celytiorja/lab-Brazo-planar/docs/marcadores_aruco.pdf

## Marcadores ArUco: teleoperación con cámara

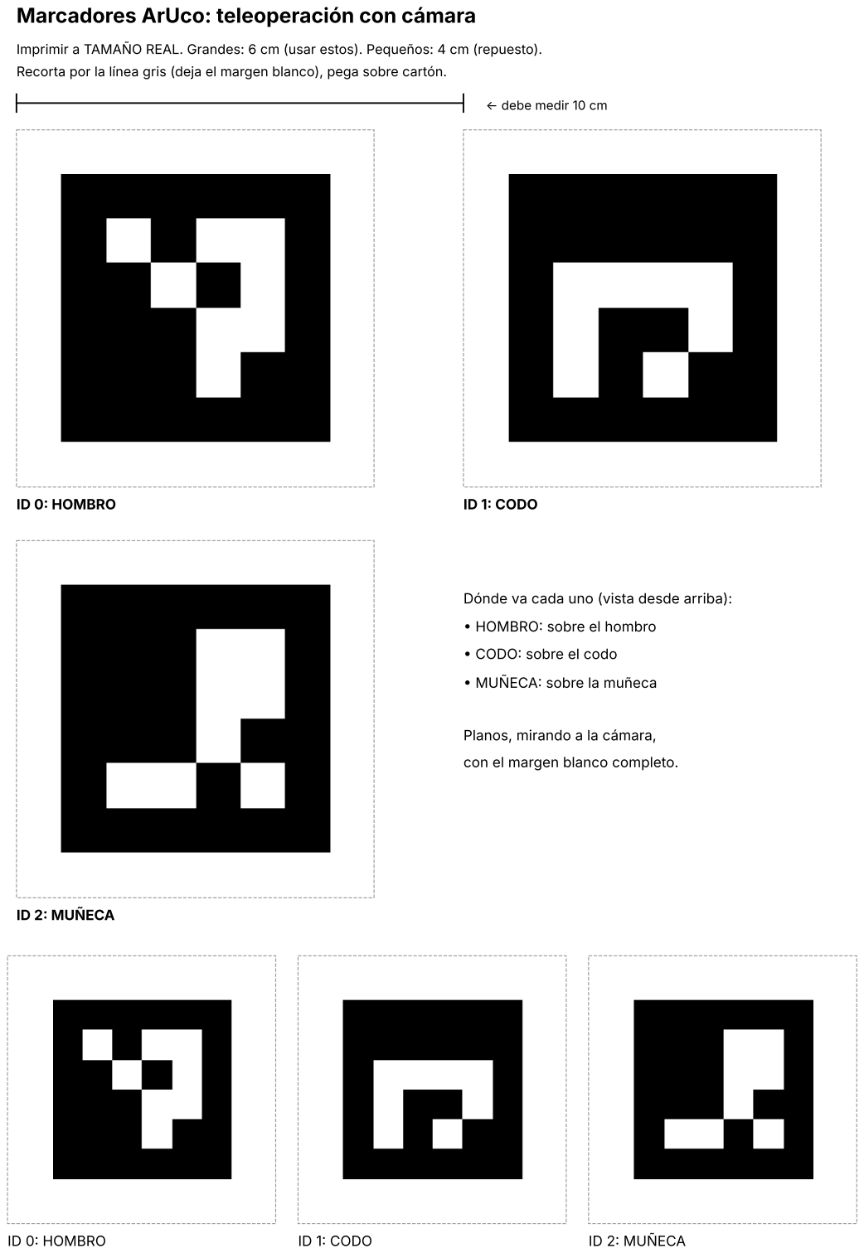
[picture p8: page 1]

Imprimir a TAMAÑO REAL. Grandes: 6 cm (usar estos). Pequeños: 4 cm (repuesto).

Recorta por la línea gris (deja el margen blanco), pega sobre cartón.

← debe medir 10 cm

ID 0: HOMBRO

ID 0: HOMBRO

ID 1: CODO

ID 1: CODO

ID 2: MUÑECA

ID 2: MUÑECA

Dónde va cada uno (vista desde arriba):
- HOMBRO: sobre el hombro
- CODO: sobre el codo
- MUÑECA: sobre la muñeca

Planos, mirando a la cámara,

con el margen blanco completo.
