celytiorja/lab-Brazo-planar/docs/05_teleoperacion_camara.md

# Teleoperación con la cámara del teléfono (Entrega 2)

El robot copia **tu brazo**. El teléfono, arriba de la mesa, ve tres marcadores impresos
(cuadros ArUco) en tu hombro, codo y muñeca.
Python calcula tus ángulos θ1 y θ2, los filtra con **Kalman** y se los manda al robot.

```
Teléfono (DroidCam, WiFi) → PC: marcadores → θ1, θ2 → Kalman → ESP32 → servos
```

## 1. Materiales (10 minutos)

### Por qué cuadros ArUco y no papeles de color

Con papeles de color el programa busca "píxeles parecidos al azul que aprendió". Eso falla
fácil: con poca luz el azul claro se vuelve **gris**, con mucha luz se vuelve **blanco**, y si
algo del fondo tiene un color parecido, lo confunde. (Fue lo que pasó con el hombro.)

Un **ArUco** es como un código QR pequeñito: borde negro y 4×4 casillas blanco/negro.

| | Papel de color | Cuadro ArUco |
|---|---|---|
| Qué busca | un tono de color | un cuadrado con borde negro y casillas |
| Con poca o mucha luz | el color cambia y se pierde | blanco y negro se distinguen siempre |
| ¿Cuál es cuál? | depende de dónde estaba antes | el cuadro **dice su número** (ID 0, 1, 2) |
| Fondo parecido | lo confunde | imposible: el código tiene bits de verificación |
| Precisión del centro | mancha de bordes difusos | 4 esquinas exactas (sub-píxel) → menos R |
| Hay que calibrar | sí (clic en cada color) | no |

Su punto débil: si te mueves **muy rápido** la imagen sale borrosa y ese cuadro no se lee.
Ahí es justo donde ayuda **Kalman**: predice con su modelo hasta que lo vuelve a ver.

### Lo que necesitas

1. **Imprimir la hoja** `docs/marcadores_aruco.pdf` a **tamaño real** (100 %, sin "ajustar
   a la página"). Mide con una regla la línea de 10 cm de la hoja. Si no tienes impresora,
   `python python/generar_marcadores.py` muestra cada cuadro para dibujarlo a mano en papel
   cuadriculado (6×6 casillas con marcador negro).
2. Recortar los **3 cuadros grandes (6 cm)** por la línea gris punteada, **dejando el margen
   blanco**, y pegarlos sobre cartón para que queden **planos**.
3. Pegarlos (cinta) **encima** de tu brazo, mirando hacia la cámara:
   **ID 0 → hombro**, **ID 1 → codo**, **ID 2 → muñeca**. Da igual cómo queden girados.
4. **El teléfono arriba de la mesa, mirando hacia abajo**, a unos 60–80 cm, con tu brazo
   completo en la imagen. Sirve un trípode, una lámpara o una caja.

## 2. El teléfono como cámara (una vez)

1. Instala **DroidCam** en el teléfono (Play Store o App Store).
2. El teléfono y el PC deben estar en la **misma red WiFi**.
3. Abre DroidCam: muestra una dirección como `WiFi IP: 192.168.1.23` y `Port: 4747`.
4. Tu fuente de video es `http://192.168.1.23:4747/video` (con tu IP).

## 3. Instalar OpenCV (una vez)

En la terminal de VS Code, con `(.venv)`:

```
git pull
pip install -r requirements.txt
```

## 4. Primera prueba, SIN robot

```
python python/teleop_camara.py --video http://192.168.1.23:4747/video
```

1. Muestra los 3 cuadros a la cámara. Cada uno aparece **enmarcado** con su color (azul
   hombro, verde codo, rojo muñeca) y unidos por una **línea amarilla**. Abajo de los
   ángulos dice `aruco: hombro:si codo:si muneca:si`.
2. Pon el brazo **estirado hacia adelante** (alejándose de ti) y pulsa **C**. Esa pose pasa a
   valer (90°, 0°), igual que la posición de inicio del robot.
3. Brazo **quieto** y pulsa **N**: durante 10 s mide cuánto "tiembla" la detección. Esa es la
   **R de la cámara**, igual que hiciste con las IMU en la Entrega 1.
4. Mueve el brazo: arriba ves los ángulos **crudos** y los de **Kalman**.

Si un cuadro no se detecta, pulsa **D** (diagnóstico): se dibujan en **rojo fino** los
cuadrados que la cámara ve pero no logra leer.

| Lo que ves | Causa probable | Arreglo |
|---|---|---|
| Ni siquiera un recuadro rojo | muy pequeño en la imagen | acerca el teléfono o usa cuadros más grandes |
| Recuadro rojo pero no se lee | borroso, doblado, brillo o sin margen blanco | pégalo en cartón, deja el margen, evita el reflejo de la lámpara |
| Se pierde solo al moverte rápido | desenfoque de movimiento | más luz (la cámara expone menos tiempo); Kalman cubre esos cuadros |
| Dice `hombro (memoria)` | el hombro no se vio en ese cuadro | normal: el hombro casi no se mueve y se usa su última posición |

Respaldo con papeles de color: `--modo color` y la tecla **L** (clic en hombro, codo y muñeca).

## 5. Con el robot

ESP32 con `firmware/adquisicion` y el Monitor Serie cerrado:

```
python python/teleop_camara.py --video http://192.168.1.23:4747/video --puerto COM3
```

- El robot **arranca en PAUSA**. Pulsa **R** para que empiece a copiarte. Hazlo con tu brazo en
  la pose de inicio, para que no dé un salto.
- **F** cambia lo que mueve al robot: **crudo** (la cámara tal cual) o **Kalman**.
- **1**, **2** y **3** cambian la configuración Q (baja, media o alta).

## 6. Grabar sesiones para la evidencia (E8 y C2)

**G** inicia y detiene la grabación. Queda en `datos/teleop/sesion_XX.csv` y **se sube sola a
GitHub**. Al salir (Q), `analisis_teleop.py` analiza todas las sesiones y sube los resultados.

Crudo y Kalman se calculan **siempre los dos**, en cada cuadro. La comparación de ángulos se hace
en los mismos cuadros y no hacen falta sesiones aparte. Lo que sí cambia según **F** es qué mueve
al robot. Por eso se graban dos sesiones con el mismo protocolo (la pantalla guía los tiempos):

| Sesión | F (mueve al robot) | 0–10 s | 10–20 s | 20–30 s |
|---|---|---|---|---|
| 1 | crudo | lento | rápido | tapa la muñeca 2 veces |
| 2 | Kalman | lento | rápido | tapa la muñeca 2 veces |

Paso a paso: `docs/PRUEBA_FINAL.md`.

## 6b. Por qué ya no "se traba" (latencia)

OpenCV guardaba los cuadros en una fila. Si el programa tardaba un poco, cada cuadro mostrado era
más viejo que el anterior y el retraso crecía hasta varios segundos. `python/video_rapido.py` lee
el video en un hilo aparte, se queda solo con el cuadro más nuevo y bota los viejos sin
decodificarlos. `python python/prueba_latencia_video.py` lo mide con un DroidCam falso:

| | edad del cuadro al inicio | después de 8 s |
|---|---|---|
| `cv2.VideoCapture` (antes) | 75 ms | **2205 ms** (crece sin parar) |
| `LectorVideo` (ahora) | 15 ms | **17 ms** |

Lo que el código no arregla es la WiFi: usa el **hotspot del teléfono** (ping de pocos ms).

## 7. Qué decir (por qué Kalman ayuda aquí)

- **La cámara tiembla** (lo mide R) y llega a ~30 cuadros/s con Δt irregular. Kalman usa el Δt
  real de cada cuadro y entrega movimientos **más suaves** al servo.
- **Si un marcador se tapa**, la cámara cruda se queda congelada. Kalman **sigue
  prediciendo** con su modelo (velocidad casi constante) hasta que vuelve a verlo.
  - Si solo se tapa la muñeca, θ1 se sigue midiendo: H se queda con su fila (**medición
    parcial**) y solo θ2 se predice.
  - Si la oclusión es larga, la velocidad estimada se frena para que el robot no siga de largo.
- **Q de la cámara:** q = r·Δt·(2π f_n)⁴ (r = varianza por cuadro medida con N; r·Δt la
  convierte en densidad). Las 3 configuraciones (f_n = 1,5 / 3 / 6 Hz) están caracterizadas en
  `resultados/<origen>/teleop/configuraciones_q_camara.md`. Q_media reduce el temblor de 8 Hz a
  la mitad con menos de 16 ms de retraso hasta 2 Hz.
- **No hay deriva**: la cámara mide el ángulo directamente. Es el complemento perfecto de las
  IMU, que no tiemblan pero derivan. **Fusionarlas** (cámara + giroscopios en tu brazo) es el
  paso siguiente; el código ya está preparado (`python/kalman_camara.py`).
