celytiorja/lab-Brazo-planar/docs/marcadores_aruco.png

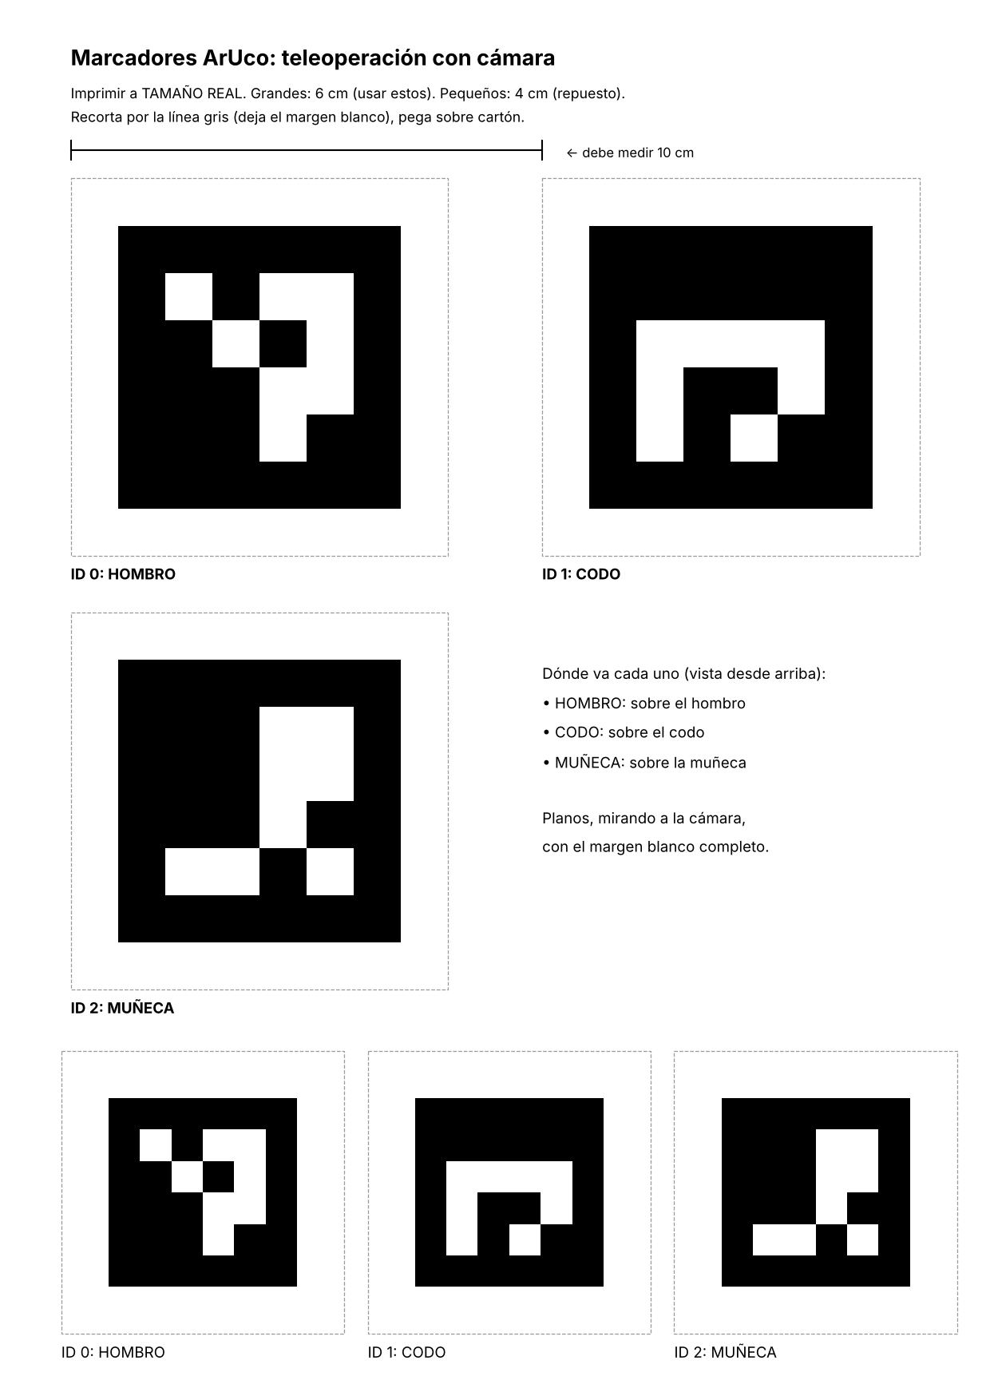
docs/marcadores_aruco.png
