celytiorja/lab-Brazo-planar/resultados/sinteticos/e1/verificacion_cinematica_resumen.md

# Verificación cinemática: resumen

| tipo | n | rmse_mm | media_mm | max_mm | sigma_resolucion_media_mm |
| --- | --- | --- | --- | --- | --- |
| todos | 20 | 5.95 | 5.831 | 8.239 | 0.9917 |
| directa | 10 | 6.21 | 6.069 | 8.239 | 1.037 |
| inversa | 10 | 5.677 | 5.593 | 7.158 | 0.9464 |

Fuentes de error (mínimos cuadrados sobre todos los puntos): offset θ1 = +0.62°, offset θ2 = +2.67°. RMSE 5.95 mm → 1.44 mm al corregirlos. Repetibilidad media 1.74 mm. Resolución de 1° ≈ 0.99 mm.
