celytiorja/lab-Brazo-planar/resultados/reales/teleop/metricas_teleop_completas.md

# Teleoperación: todas las métricas

| sesion | robot_movido_con | duracion_s | cuadros | fps | dt_medio_ms | dt_std_ms | dt_max_ms | visto_pct | solo_theta1_pct | hombro_memoria_pct | oclusiones | oclusion_max_ms | aspereza_theta1_crudo | aspereza_theta1_kf | aspereza_theta2_crudo | aspereza_theta2_kf | ordenes_s_crudo | ordenes_s_kf | cambios_dir_s_hombro_crudo | cambios_dir_s_hombro_kf | cambios_dir_s_codo_crudo | cambios_dir_s_codo_kf | retraso_kf_theta1_ms | retraso_kf_theta2_ms | t_kalman_us_medio | t_kalman_us_p95 | t_proc_ms_medio | t_proc_ms_p95 | carga_pct | imu_robot_valida_pct | retraso_orden_robot_hombro_ms | error_seguimiento_hombro_deg | retraso_camara_robot_hombro_ms | vibracion_robot_hombro_dps | retraso_orden_robot_codo_ms | error_seguimiento_codo_deg | retraso_camara_robot_codo_ms | vibracion_robot_codo_dps | imu_robot_falla_t_s |
| --- | --- | --- | --- | --- | --- | --- | --- | --- | --- | --- | --- | --- | --- | --- | --- | --- | --- | --- | --- | --- | --- | --- | --- | --- | --- | --- | --- | --- | --- | --- | --- | --- | --- | --- | --- | --- | --- | --- | --- |
| sesion_01 | kalman | 73.65 | 1102 | 14.95 | 66.89 | 80.43 | 781.9 | 83.48 | 16.52 | 1.452 | 34 | 1863 | 1.436 | 1.184 | 2.945 | 2.069 | 4.847 | 5.798 | 0.7468 | 0.7875 | 0.6925 | 0.8011 | 5 | 5 | 260.1 | 426.8 | 6.377 | 13.69 | 9.533 | 100 | 200 | 2.3 | 210 | 3.258 | 170 | 4.02 | 205 | 8.832 | — |
| sesion_02 | sin robot | 7.361 | 96 | 12.91 | 77.49 | 69.04 | 381.9 | 100 | 0 | 0 | 0 | 0 | 0.1631 | 0.1315 | 1.447 | 0.9537 | 4.211 | 4.211 | 0.5434 | 0.5434 | 0.6792 | 0.6792 | 5 | 5 | 297.4 | 534.5 | 6.758 | 12.03 | 8.722 | — | — | — | — | — | — | — | — | — | — |
| sesion_03 | crudo | 43.55 | 495 | 11.34 | 88.15 | 139.7 | 2174 | 94.34 | 5.657 | 0 | 2 | 2996 | 0.8636 | 0.6696 | 2.204 | 1.654 | 3.353 | 3.605 | 0.3215 | 0.3215 | 0.2985 | 0.2985 | 5 | 5 | 269.2 | 433.3 | 6.585 | 11.91 | 7.471 | 86.19 | 185 | 0.9911 | 220 | 1.863 | 175 | 3.388 | 200 | 6.46 | 37.79 |
| sesion_04 | kalman | 38.05 | 523 | 13.72 | 72.9 | 132.7 | 2298 | 95.98 | 4.015 | 0 | 3 | 705.4 | 0.9866 | 0.7231 | 2.822 | 2.088 | 4.336 | 4.862 | 0.8146 | 0.8672 | 0.5519 | 0.6044 | 10 | 10 | 261.5 | 420.1 | 6.374 | 11.32 | 8.744 | 0 | — | — | — | — | — | — | — | — | 0.1582 |
