celytiorja/lab-Brazo-planar/resultados/reales/e1/estadisticas_estatico.md

# Estadística en reposo

| canal | unidad | media | varianza | desv_est | min | max |
| --- | --- | --- | --- | --- | --- | --- |
| ax1 | g | 0.0008008 | 6.24e-06 | 0.002498 | -0.007935 | 0.009521 |
| gx1 | °/s | -4.87 | 0.001793 | 0.04234 | -5.069 | -4.58 |
| ay1 | g | -0.005908 | 2.72e-06 | 0.001649 | -0.01257 | 0.002563 |
| gy1 | °/s | 0.844 | 0.001315 | 0.03627 | 0.626 | 1.099 |
| az1 | g | 1.033 | 5.408e-06 | 0.002326 | 1.022 | 1.048 |
| gz1 | °/s | 0.2604 | 0.0008918 | 0.02986 | 0.1679 | 0.3664 |
| ax2 | g | 0.04436 | 3.035e-06 | 0.001742 | 0.03784 | 0.05042 |
| gx2 | °/s | -3.484 | 0.001486 | 0.03854 | -3.847 | -3.237 |
| ay2 | g | -0.02976 | 2.034e-06 | 0.001426 | -0.03528 | -0.02405 |
| gy2 | °/s | -0.3958 | 0.002571 | 0.0507 | -0.6565 | -0.07634 |
| az2 | g | 0.9215 | 6.733e-06 | 0.002595 | 0.9115 | 0.9342 |
| gz2 | °/s | -0.504 | 0.001062 | 0.03259 | -0.6412 | -0.3817 |
| w1 (giro en el plano) | °/s | 0.2604 | 0.0008918 | 0.02986 | 0.1679 | 0.3664 |
| w2 (giro en el plano) | °/s | -0.504 | 0.001062 | 0.03259 | -0.6412 | -0.3817 |

Archivo: estatico_03. Generado por código · commit 54720e5+cambios_sin_commit · manifiesto datos/crudos/manifiesto.json
