celytiorja/lab-Brazo-planar/resultados/reales/e1/sensibilidad_ventana.md

# Sensibilidad al tamaño de ventana N

| N | eslabon | ruido_omega_reposo_dps | ruido_teorico_dps | retraso_ms | retraso_teorico_ms | error_estacionario_rms_deg | deriva_final_deg |
| --- | --- | --- | --- | --- | --- | --- | --- |
| 1 | 1 | 0.02987 | 0.02986 | 0 | 0 | 5.759 | 6.004 |
| 1 | 2 | 0.03259 | 0.03259 | 0 | 0 | 4.425 | 7.698 |
| 3 | 1 | 0.02003 | 0.01724 | 9.22 | 10 | 5.759 | 6.003 |
| 3 | 2 | 0.0211 | 0.01881 | 9.822 | 10 | 4.425 | 7.697 |
| 5 | 1 | 0.01629 | 0.01336 | 19.2 | 20 | 5.758 | 6.002 |
| 5 | 2 | 0.01676 | 0.01457 | 19.81 | 20 | 4.425 | 7.697 |
| 9 | 1 | 0.01261 | 0.009955 | 39.16 | 40 | 5.758 | 6 |
| 9 | 2 | 0.01262 | 0.01086 | 39.79 | 40 | 4.424 | 7.696 |
| 15 | 1 | 0.01021 | 0.007711 | 69.07 | 70 | 5.76 | 5.998 |
| 15 | 2 | 0.009736 | 0.008414 | 69.76 | 70 | 4.421 | 7.693 |
| 21 | 1 | 0.008977 | 0.006517 | 98.95 | 100 | 5.763 | 5.995 |
| 21 | 2 | 0.008139 | 0.007111 | 99.72 | 100 | 4.421 | 7.691 |
| 31 | 1 | 0.007774 | 0.005364 | 148.7 | 150 | 5.799 | 5.992 |
| 31 | 2 | 0.006682 | 0.005853 | 149.7 | 150 | 4.468 | 7.688 |
| 51 | 1 | 0.006604 | 0.004182 | 247.9 | 250 | 6.334 | 5.985 |
| 51 | 2 | 0.005133 | 0.004563 | 249.5 | 250 | 5.287 | 7.683 |

Media móvil de ruido blanco: σ_N = σ/√N y retraso (N−1)/2 muestras. La deriva final NO cambia con N: promediar no quita el sesgo.
