celytiorja/lab-Brazo-planar/resultados/reales/e2/compromiso_Q_R.md

# Barrido de q (compromiso Q/R)

| archivo | f_objetivo_hz | q | q_dt_sobre_r | K_omega_estacionaria | f_corte_hz | ruido_omega_reposo_puro_dps | ruido_omega_reposo_perfil_dps | retraso_omega_ms |
| --- | --- | --- | --- | --- | --- | --- | --- | --- |
| escalones_01 | 0.3 | 3.471e-05 | 0.0003892 | 0.01867 | 0.3 | 0.00449 | 0.289 | 128.6 |
| escalones_01 | 0.426 | 6.999e-05 | 0.0007848 | 0.02641 | 0.426 | 0.005071 | 0.1005 | 113.3 |
| escalones_01 | 0.604 | 0.0001407 | 0.001578 | 0.03724 | 0.604 | 0.00579 | 0.07442 | 98.05 |
| escalones_01 | 0.856 | 0.0002826 | 0.003169 | 0.05236 | 0.856 | 0.006668 | 0.08821 | 82.32 |
| escalones_01 | 1.214 | 0.0005686 | 0.006376 | 0.07344 | 1.214 | 0.007734 | 0.1059 | 66.98 |
| escalones_01 | 1.722 | 0.001145 | 0.01283 | 0.1025 | 1.722 | 0.00901 | 0.1269 | 52.92 |
| escalones_01 | 2.442 | 0.002304 | 0.02584 | 0.1422 | 2.442 | 0.01052 | 0.1517 | 40.53 |
| escalones_01 | 3.464 | 0.004646 | 0.05209 | 0.1956 | 3.464 | 0.01229 | 0.1801 | 29.84 |
| escalones_01 | 4.913 | 0.009382 | 0.1052 | 0.2656 | 4.913 | 0.01433 | 0.2114 | 20.98 |
| escalones_01 | 6.969 | 0.01903 | 0.2134 | 0.3546 | 6.969 | 0.01665 | 0.2439 | 13.99 |
| escalones_01 | 9.884 | 0.0389 | 0.4362 | 0.4626 | 9.884 | 0.0192 | 0.2755 | 9.198 |
| escalones_01 | 14.02 | 0.08082 | 0.9062 | 0.5856 | 14.02 | 0.02193 | 0.3039 | 5.544 |
| escalones_01 | 19.88 | 0.1734 | 1.944 | 0.7133 | 19.88 | 0.0247 | 0.3271 | 3.1 |
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
| seno_rapido_01 | 28.2 | 0.3959 | 4.439 | 0.83 | 28.2 | 0.02726 | 0.04245 | 1.357 |
| seno_rapido_01 | 40 | 1.018 | 11.42 | 0.919 | 40 | 0.02929 | 0.04454 | 0.5926 |

Generado por código · commit 54720e5+cambios_sin_commit · manifiesto datos/crudos/manifiesto.json
