celytiorja/lab-Brazo-planar/resultados/reales/e2/ruido_reposo_puro.md

# Ruido de ω en reposo puro (estatico_03)

| metodo | ruido_omega_reposo_puro_dps |
| --- | --- |
| Integración directa | 0.03123 |
| Media móvil N=5 + Euler | 0.01655 |
| Media móvil N=21 + Euler | 0.008579 |
| Kalman Q_baja | 0.008479 |
| Kalman Q_media | 0.01444 |
| Kalman Q_alta | 0.02247 |

σ de la velocidad estimada con el brazo quieto (sin movimiento previo). Mide SOLO ruido, sin mezclar retraso.

Generado por código · commit 54720e5+cambios_sin_commit · manifiesto datos/crudos/manifiesto.json
