celytiorja/lab-Brazo-planar/resultados/sinteticos/e1/estadisticas_estatico.md

# Estadística en reposo

| canal | unidad | media | varianza | desv_est | min | max |
| --- | --- | --- | --- | --- | --- | --- |
| ax1 | g | -6.334e-06 | 9.342e-06 | 0.003056 | -0.009888 | 0.01123 |
| gx1 | °/s | 0.001145 | 0.003506 | 0.05921 | -0.2137 | 0.2137 |
| ay1 | g | -1.799e-05 | 9.143e-06 | 0.003024 | -0.009766 | 0.01074 |
| gy1 | °/s | -0.0001756 | 0.003512 | 0.05927 | -0.1832 | 0.1985 |
| az1 | g | 1 | 8.92e-06 | 0.002987 | 0.9891 | 1.012 |
| gz1 | °/s | 0.355 | 0.003665 | 0.06054 | 0.1374 | 0.5802 |
| ax2 | g | -1.067e-05 | 9.332e-06 | 0.003055 | -0.01001 | 0.01038 |
| gx2 | °/s | 0.0002023 | 0.003642 | 0.06035 | -0.1985 | 0.2137 |
| ay2 | g | -1.735e-05 | 8.95e-06 | 0.002992 | -0.009949 | 0.01007 |
| gy2 | °/s | 0.0009201 | 0.003638 | 0.06031 | -0.1985 | 0.229 |
| az2 | g | 1 | 9.392e-06 | 0.003065 | 0.9883 | 1.01 |
| gz2 | °/s | 0.1135 | 0.003541 | 0.0595 | -0.1374 | 0.3511 |
| w1 (giro en el plano) | °/s | 0.355 | 0.003665 | 0.06054 | 0.1374 | 0.5802 |
| w2 (giro en el plano) | °/s | 0.1135 | 0.003541 | 0.0595 | -0.1374 | 0.3511 |

Archivo: estatico_01. Generado por código · commit 54720e5+cambios_sin_commit · manifiesto datos/sinteticos/manifiesto.json
