celytiorja/lab-Brazo-planar/resultados/sinteticos/e1/sensibilidad_ventana.md

# Sensibilidad al tamaño de ventana N

| N | eslabon | ruido_omega_reposo_dps | ruido_teorico_dps | retraso_ms | retraso_teorico_ms | error_estacionario_rms_deg | deriva_final_deg |
| --- | --- | --- | --- | --- | --- | --- | --- |
| 1 | 1 | 0.06053 | 0.06054 | 0 | 0 | 0.6587 | 0.01602 |
| 1 | 2 | 0.0595 | 0.0595 | 0 | 0 | 0.8674 | -1.433 |
| 3 | 1 | 0.0349 | 0.03495 | 9.298 | 10 | 0.658 | 0.008009 |
| 3 | 2 | 0.03457 | 0.03436 | 9.822 | 10 | 0.8626 | -1.428 |
| 5 | 1 | 0.02665 | 0.02708 | 19.27 | 20.01 | 0.6586 | 0.006762 |
| 5 | 2 | 0.02653 | 0.02661 | 19.82 | 20.01 | 0.8612 | -1.425 |
| 9 | 1 | 0.01982 | 0.02018 | 39.22 | 40.02 | 0.6602 | 0.003101 |
| 9 | 2 | 0.0195 | 0.01983 | 39.82 | 40.02 | 0.8626 | -1.431 |
| 15 | 1 | 0.01545 | 0.01563 | 69.11 | 70.03 | 0.6588 | 0.004291 |
| 15 | 2 | 0.01484 | 0.01536 | 69.81 | 70.03 | 0.8611 | -1.427 |
| 21 | 1 | 0.01311 | 0.01321 | 98.97 | 100 | 0.6581 | 0.001291 |
| 21 | 2 | 0.01252 | 0.01299 | 99.79 | 100 | 0.8583 | -1.426 |
| 31 | 1 | 0.01073 | 0.01087 | 148.7 | 150.1 | 0.6537 | 0.001621 |
| 31 | 2 | 0.01046 | 0.01069 | 149.7 | 150.1 | 0.8564 | -1.427 |
| 51 | 1 | 0.008312 | 0.008478 | 247.9 | 250.1 | 0.8885 | -0.002739 |
| 51 | 2 | 0.008283 | 0.008332 | 249.6 | 250.1 | 1.155 | -1.43 |

Media móvil de ruido blanco: σ_N = σ/√N y retraso (N−1)/2 muestras. La deriva final NO cambia con N: promediar no quita el sesgo.
