celytiorja/lab-Brazo-planar/resultados/sinteticos/e2/compromiso_Q_R.md

# Barrido de q (compromiso Q/R)

| archivo | f_objetivo_hz | q | q_dt_sobre_r | K_omega_estacionaria | f_corte_hz | ruido_omega_reposo_puro_dps | ruido_omega_reposo_perfil_dps | retraso_omega_ms |
| --- | --- | --- | --- | --- | --- | --- | --- | --- |
| escalones_01 | 0.3 | 0.0001281 | 0.0003496 | 0.01868 | 0.3 | 0.005825 | 0.3291 | 123.5 |
| escalones_01 | 0.426 | 0.0002583 | 0.0007049 | 0.02642 | 0.426 | 0.006866 | 0.09266 | 107.3 |
| escalones_01 | 0.604 | 0.0005192 | 0.001417 | 0.03725 | 0.604 | 0.00812 | 0.01655 | 91.46 |
| escalones_01 | 0.856 | 0.001043 | 0.002847 | 0.05238 | 0.856 | 0.009632 | 0.009384 | 75.28 |
| escalones_01 | 1.214 | 0.002098 | 0.005727 | 0.07347 | 1.214 | 0.01146 | 0.01116 | 60.01 |
| escalones_01 | 1.722 | 0.004224 | 0.01153 | 0.1026 | 1.722 | 0.01367 | 0.01348 | 46.02 |
| escalones_01 | 2.442 | 0.008503 | 0.02321 | 0.1423 | 2.442 | 0.01631 | 0.01617 | 34.3 |
| escalones_01 | 3.464 | 0.01714 | 0.04679 | 0.1957 | 3.464 | 0.01948 | 0.01928 | 24.93 |
| escalones_01 | 4.913 | 0.03462 | 0.0945 | 0.2657 | 4.913 | 0.02325 | 0.02285 | 17.71 |
| escalones_01 | 6.969 | 0.07022 | 0.1917 | 0.3547 | 6.969 | 0.0277 | 0.02697 | 11.88 |
| escalones_01 | 9.884 | 0.1435 | 0.3918 | 0.4627 | 9.884 | 0.03284 | 0.03174 | 7.288 |
| escalones_01 | 14.02 | 0.2982 | 0.814 | 0.5857 | 14.02 | 0.03862 | 0.03716 | 3.905 |
| escalones_01 | 19.88 | 0.6398 | 1.746 | 0.7135 | 19.88 | 0.04473 | 0.04305 | 2.217 |
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
| seno_rapido_01 | 28.2 | 1.46 | 3.984 | 0.83 | 28.2 | 0.05059 | 0.04635 | 0.6632 |
| seno_rapido_01 | 40 | 3.757 | 10.25 | 0.919 | 40 | 0.05535 | 0.05142 | 0.2878 |

Generado por código · commit 54720e5+cambios_sin_commit · manifiesto datos/sinteticos/manifiesto.json
