celytiorja/lab-Brazo-planar/resultados/sinteticos/e2/ruido_reposo_puro.md

# Ruido de ω en reposo puro (estatico_01)

| metodo | ruido_omega_reposo_puro_dps |
| --- | --- |
| Integración directa | 0.05997 |
| Media móvil N=5 + Euler | 0.02655 |
| Media móvil N=21 + Euler | 0.01275 |
| Kalman Q_baja | 0.01275 |
| Kalman Q_media | 0.02346 |
| Kalman Q_alta | 0.03979 |

σ de la velocidad estimada con el brazo quieto (sin movimiento previo). Mide SOLO ruido, sin mezclar retraso.

Generado por código · commit 54720e5+cambios_sin_commit · manifiesto datos/sinteticos/manifiesto.json
