celytiorja/lab-Brazo-planar/resultados/sinteticos/e1/verificacion_cinematica.md

# Verificación cinemática por punto

| id | tipo | repeticion | servo_h | servo_c | x_teo_mm | y_teo_mm | x_med_mm | y_med_mm | error_mm | error_vs_objetivo_mm | sigma_resolucion_mm |
| --- | --- | --- | --- | --- | --- | --- | --- | --- | --- | --- | --- |
| P01 | directa | 1 | 45 | 90 | 134.3 | 134.3 | 131.1 | 137.9 | 4.813 | — | 1.049 |
| P01 | directa | 2 | 45 | 90 | 134.3 | 134.3 | 130.1 | 136.2 | 4.635 | — | 1.049 |
| P02 | directa | 1 | 90 | 90 | 0 | 190 | -7.1 | 189.4 | 7.125 | — | 1.049 |
| P02 | directa | 2 | 90 | 90 | 0 | 190 | -6.4 | 188.8 | 6.512 | — | 1.049 |
| P03 | directa | 1 | 135 | 90 | -134.3 | 134.3 | -140.7 | 129.1 | 8.239 | — | 1.049 |
| P03 | directa | 2 | 135 | 90 | -134.3 | 134.3 | -139.7 | 129.7 | 7.088 | — | 1.049 |
| P04 | directa | 1 | 60 | 60 | 126.1 | 133.4 | 123.3 | 138.4 | 5.709 | — | 1.019 |
| P04 | directa | 2 | 60 | 60 | 126.1 | 133.4 | 123.1 | 135.8 | 3.831 | — | 1.019 |
| P05 | directa | 1 | 120 | 120 | -126.1 | 133.4 | -129.6 | 129.1 | 5.561 | — | 1.019 |
| P05 | directa | 2 | 120 | 120 | -126.1 | 133.4 | -130 | 127.4 | 7.176 | — | 1.019 |
| P06 | inversa | 1 | 51 | 31 | 150.2 | 69.77 | 148.9 | 76.8 | 7.158 | 6.888 | 0.9381 |
| P06 | inversa | 2 | 51 | 31 | 150.2 | 69.77 | 150.6 | 74.7 | 4.942 | 4.738 | 0.9381 |
| P07 | inversa | 1 | 66 | 143 | 1.5 | 170.3 | -4.1 | 168.3 | 5.933 | 4.438 | 0.9588 |
| P07 | inversa | 2 | 66 | 143 | 1.5 | 170.3 | -4.3 | 167.7 | 6.34 | 4.876 | 0.9588 |
| P08 | inversa | 1 | 106 | 148 | -110.7 | 124.4 | -112.9 | 119.6 | 5.265 | 6.129 | 0.9417 |
| P08 | inversa | 2 | 106 | 148 | -110.7 | 124.4 | -114.3 | 118.4 | 6.989 | 7.877 | 0.9417 |
| P09 | inversa | 1 | 38 | 143 | 81.26 | 149.6 | 76 | 151.3 | 5.519 | 4.206 | 0.9588 |
| P09 | inversa | 2 | 38 | 143 | 81.26 | 149.6 | 77.5 | 149 | 3.812 | 2.693 | 0.9588 |
| P10 | inversa | 1 | 41 | 30 | 159.6 | 41.21 | 160.5 | 46 | 4.872 | 6.021 | 0.9345 |
| P10 | inversa | 2 | 41 | 30 | 159.6 | 41.21 | 161.6 | 45.9 | 5.095 | 6.113 | 0.9345 |

error_mm: medido vs teórico de los ángulos ENVIADOS (error del modelo/brazo). error_vs_objetivo: en inversa, medido vs punto pedido (incluye redondear a 1°). sigma_resolucion: error esperado SOLO por la resolución de 1° del servo.
