celytiorja/lab-Brazo-planar/resultados/reales/teleop/metricas_teleop_completas.csv

sesion | robot_movido_con | duracion_s | cuadros | fps | dt_medio_ms | dt_std_ms | dt_max_ms | visto_pct | solo_theta1_pct | hombro_memoria_pct | oclusiones | oclusion_max_ms | aspereza_theta1_crudo | aspereza_theta1_kf | aspereza_theta2_crudo | aspereza_theta2_kf | ordenes_s_crudo | ordenes_s_kf | cambios_dir_s_hombro_crudo | cambios_dir_s_hombro_kf | cambios_dir_s_codo_crudo | cambios_dir_s_codo_kf | retraso_kf_theta1_ms | retraso_kf_theta2_ms | t_kalman_us_medio | t_kalman_us_p95 | t_proc_ms_medio | t_proc_ms_p95 | carga_pct | imu_robot_valida_pct | retraso_orden_robot_hombro_ms | error_seguimiento_hombro_deg | retraso_camara_robot_hombro_ms | vibracion_robot_hombro_dps | retraso_orden_robot_codo_ms | error_seguimiento_codo_deg | retraso_camara_robot_codo_ms | vibracion_robot_codo_dps | imu_robot_falla_t_s
sesion_01 | kalman | 73.6506 | 1102 | 14.949 | 66.8943 | 80.4349 | 781.9 | 83.4846 | 16.5154 | 1.45191 | 34 | 1862.9 | 1.43594 | 1.18421 | 2.94508 | 2.06855 | 4.84721 | 5.79764 | 0.746769 | 0.787502 | 0.692459 | 0.80108 | 5 | 5 | 260.113 | 426.765 | 6.37736 | 13.686 | 9.53349 | 100 | 200 | 2.29967 | 210 | 3.25811 | 170 | 4.02017 | 205 | 8.83229
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
