celytiorja/lab-Brazo-planar/datos/sinteticos/verificacion_cinematica.csv

# SINTÉTICO: medidas inventadas con offset oculto (0.8 | 2.5) ° | juego σ=0.4° | regla σ=0.7 mm. NO son mediciones.
# L1_mm=105.0 L2_mm=85.0 hombro_offset=0.0 hombro_signo=1 codo_offset=90.0 codo_signo=1
# Origen = eje del hombro; x = dirección de θ1 = 0; y perpendicular (θ1 = 90°). Medir la punta en mm.
id | tipo | repeticion | servo_h | servo_c | theta1_deg | theta2_deg | x_obj_mm | y_obj_mm | x_teo_mm | y_teo_mm | x_med_mm | y_med_mm
P01 | directa | 1 | 45 | 90 | 45.0 | 0.0 |  |  | 134.35 | 134.35 | 131.1 | 137.9
P01 | directa | 2 | 45 | 90 | 45.0 | 0.0 |  |  | 134.35 | 134.35 | 130.1 | 136.2
P02 | directa | 1 | 90 | 90 | 90.0 | 0.0 |  |  | 0.0 | 190.0 | -7.1 | 189.4
P02 | directa | 2 | 90 | 90 | 90.0 | 0.0 |  |  | 0.0 | 190.0 | -6.4 | 188.8
P03 | directa | 1 | 135 | 90 | 135.0 | 0.0 |  |  | -134.35 | 134.35 | -140.7 | 129.1
P03 | directa | 2 | 135 | 90 | 135.0 | 0.0 |  |  | -134.35 | 134.35 | -139.7 | 129.7
P04 | directa | 1 | 60 | 60 | 60.0 | -30.0 |  |  | 126.11 | 133.43 | 123.3 | 138.4
P04 | directa | 2 | 60 | 60 | 60.0 | -30.0 |  |  | 126.11 | 133.43 | 123.1 | 135.8
P05 | directa | 1 | 120 | 120 | 120.0 | 30.0 |  |  | -126.11 | 133.43 | -129.6 | 129.1
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
