celytiorja/lab-Brazo-planar/resultados/reales/e1/estadisticas_estatico.csv

canal | unidad | media | varianza | desv_est | min | max
ax1 | g | 0.000800768 | 6.24032e-06 | 0.00249806 | -0.00793457 | 0.00952148
gx1 | °/s | -4.86973 | 0.00179256 | 0.0423387 | -5.0687 | -4.58015
ay1 | g | -0.00590822 | 2.71987e-06 | 0.0016492 | -0.0125732 | 0.00256348
gy1 | °/s | 0.844004 | 0.00131516 | 0.0362652 | 0.625954 | 1.09924
az1 | g | 1.03301 | 5.40844e-06 | 0.00232561 | 1.02185 | 1.04797
gz1 | °/s | 0.2604 | 0.000891837 | 0.0298636 | 0.167939 | 0.366412
ax2 | g | 0.0443594 | 3.03452e-06 | 0.00174199 | 0.0378418 | 0.050415
gx2 | °/s | -3.48411 | 0.00148569 | 0.0385447 | -3.84733 | -3.23664
ay2 | g | -0.0297555 | 2.03423e-06 | 0.00142626 | -0.0352783 | -0.0240479
gy2 | °/s | -0.395834 | 0.00257061 | 0.0507012 | -0.656489 | -0.0763359
az2 | g | 0.921538 | 6.73276e-06 | 0.00259476 | 0.911499 | 0.934204
gz2 | °/s | -0.504008 | 0.00106182 | 0.0325855 | -0.641221 | -0.381679
w1 (giro en el plano) | °/s | 0.2604 | 0.000891837 | 0.0298636 | 0.167939 | 0.366412
w2 (giro en el plano) | °/s | -0.504008 | 0.00106182 | 0.0325855 | -0.641221 | -0.381679
