celytiorja/lab-Brazo-planar/resultados/sinteticos/teleop/metricas_teleop_completas.md

# Teleoperación: todas las métricas

| sesion | robot_movido_con | duracion_s | cuadros | fps | dt_medio_ms | dt_std_ms | dt_max_ms | visto_pct | solo_theta1_pct | hombro_memoria_pct | oclusiones | oclusion_max_ms | aspereza_theta1_crudo | aspereza_theta1_kf | aspereza_theta2_crudo | aspereza_theta2_kf | ordenes_s_crudo | ordenes_s_kf | cambios_dir_s_hombro_crudo | cambios_dir_s_hombro_kf | cambios_dir_s_codo_crudo | cambios_dir_s_codo_kf | retraso_kf_theta1_ms | retraso_kf_theta2_ms | t_kalman_us_medio | t_kalman_us_p95 | t_proc_ms_medio | t_proc_ms_p95 | carga_pct | rmse_theta1_crudo | rmse_theta1_kf | rmse_oclusion_theta1_crudo | rmse_oclusion_theta1_kf | rmse_theta2_crudo | rmse_theta2_kf | rmse_oclusion_theta2_crudo | rmse_oclusion_theta2_kf | retraso_orden_robot_hombro_ms | error_seguimiento_hombro_deg | retraso_camara_robot_hombro_ms | vibracion_robot_hombro_dps | retraso_orden_robot_codo_ms | error_seguimiento_codo_deg | retraso_camara_robot_codo_ms | vibracion_robot_codo_dps |
| --- | --- | --- | --- | --- | --- | --- | --- | --- | --- | --- | --- | --- | --- | --- | --- | --- | --- | --- | --- | --- | --- | --- | --- | --- | --- | --- | --- | --- | --- | --- | --- | --- | --- | --- | --- | --- | --- | --- | --- | --- | --- | --- | --- | --- | --- |
| sesion_01 | crudo | 29.97 | 900 | 30 | 33.33 | 5.64 | 50.5 | 92.56 | 7.444 | 0 | 3 | 1263 | 0.8096 | 0.501 | 1.882 | 0.931 | 14.62 | 15.62 | 1.101 | 0.901 | 1.101 | 0.9678 | 0 | 5 | 240.2 | 313.2 | 2.926 | 3.81 | 8.778 | 0.334 | 0.3785 | 19.08 | 0.2449 | 1.218 | 1.372 | 14.73 | 12.81 | 175 | 1.1 | 210 | 12.12 | 170 | 1.445 | 210 | 15.29 |
| sesion_02 | kalman | 29.97 | 900 | 30 | 33.33 | 5.64 | 50.5 | 92.56 | 7.444 | 0 | 3 | 1263 | 0.8096 | 0.501 | 1.882 | 0.931 | 14.62 | 15.62 | 1.101 | 0.901 | 1.101 | 0.9678 | 0 | 5 | 183.7 | 265.3 | 2.661 | 3.48 | 7.983 | 0.334 | 0.3785 | 19.08 | 0.2449 | 1.218 | 1.372 | 14.73 | 12.81 | 180 | 0.8281 | 210 | 9.501 | 170 | 1.485 | 215 | 15.65 |

> ⚠️ DATOS SINTÉTICOS: video generado por código para probar el análisis. No son mediciones.
