celytiorja/lab-Brazo-planar/resultados/sinteticos/teleop/metricas_teleop_completas.csv

sesion | robot_movido_con | duracion_s | cuadros | fps | dt_medio_ms | dt_std_ms | dt_max_ms | visto_pct | solo_theta1_pct | hombro_memoria_pct | oclusiones | oclusion_max_ms | aspereza_theta1_crudo | aspereza_theta1_kf | aspereza_theta2_crudo | aspereza_theta2_kf | ordenes_s_crudo | ordenes_s_kf | cambios_dir_s_hombro_crudo | cambios_dir_s_hombro_kf | cambios_dir_s_codo_crudo | cambios_dir_s_codo_kf | retraso_kf_theta1_ms | retraso_kf_theta2_ms | t_kalman_us_medio | t_kalman_us_p95 | t_proc_ms_medio | t_proc_ms_p95 | carga_pct | rmse_theta1_crudo | rmse_theta1_kf | rmse_oclusion_theta1_crudo | rmse_oclusion_theta1_kf | rmse_theta2_crudo | rmse_theta2_kf | rmse_oclusion_theta2_crudo | rmse_oclusion_theta2_kf | retraso_orden_robot_hombro_ms | error_seguimiento_hombro_deg | retraso_camara_robot_hombro_ms | vibracion_robot_hombro_dps | retraso_orden_robot_codo_ms | error_seguimiento_codo_deg | retraso_camara_robot_codo_ms | vibracion_robot_codo_dps
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
