celytiorja/lab-Brazo-planar/resultados/reales/e1/01_reposo_senales_histogramas.png

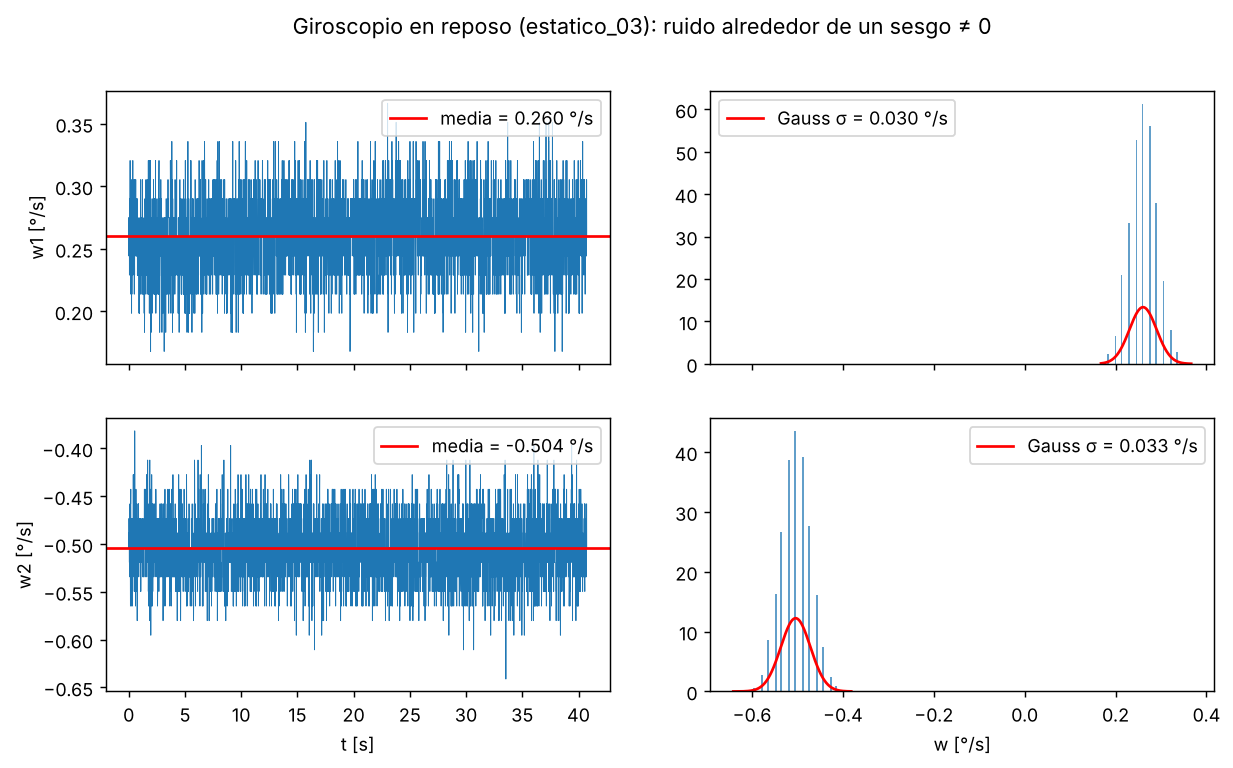
resultados/reales/e1/01_reposo_senales_histogramas.png
