celytiorja/lab-Brazo-planar/resultados/reales/e1/03_matriz_R.png

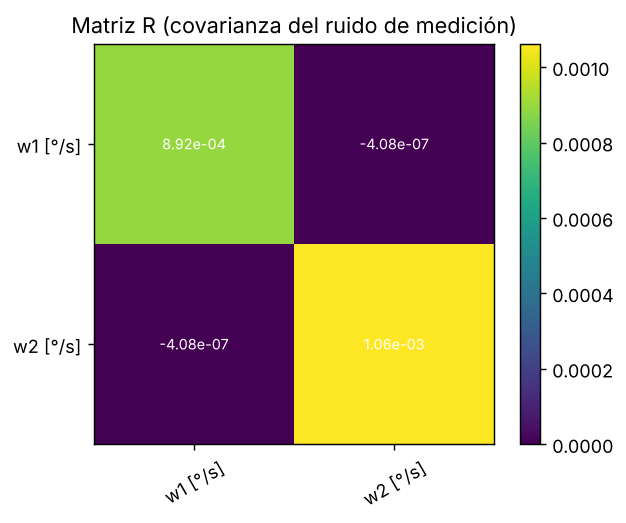
resultados/reales/e1/03_matriz_R.png
