celytiorja/lab-Brazo-planar/resultados/reales/e1/04_histograma_dt.png

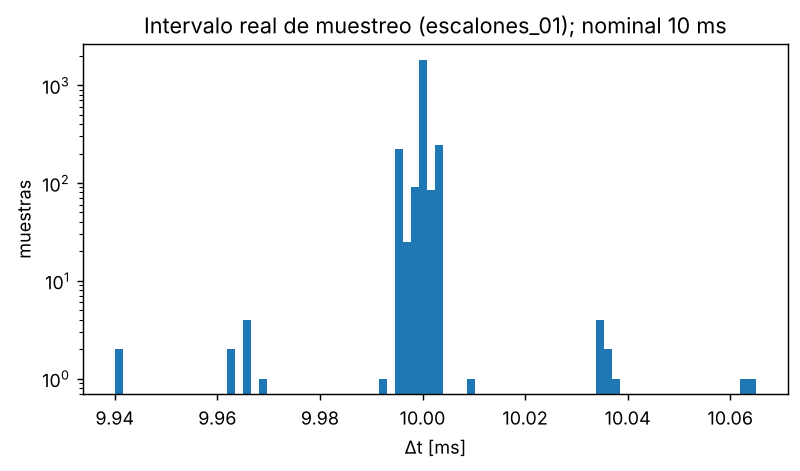
resultados/reales/e1/04_histograma_dt.png
