celytiorja/lab-Brazo-planar/resultados/reales/e1/05_deriva_en_reposo.png

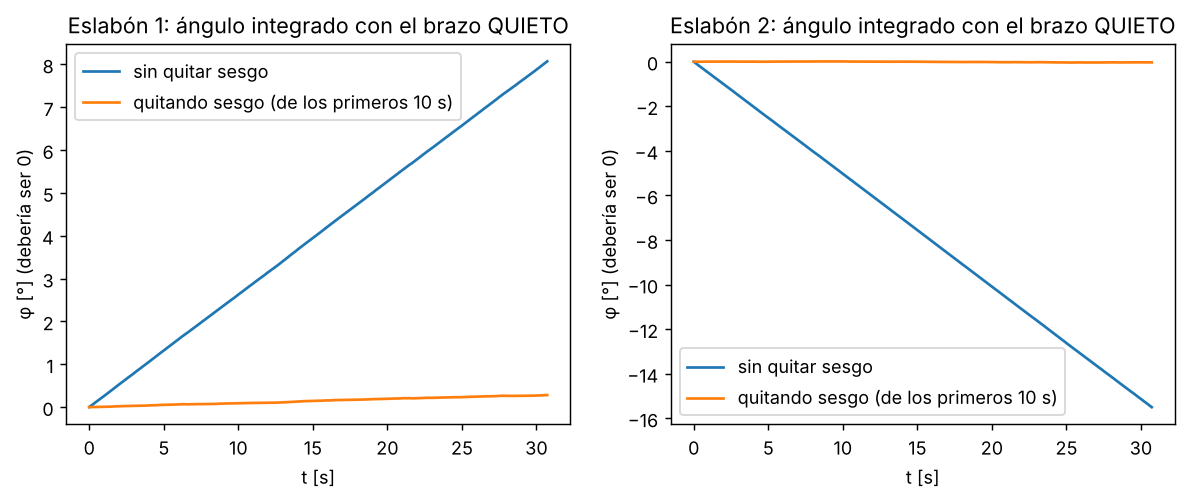
resultados/reales/e1/05_deriva_en_reposo.png
