celytiorja/lab-Brazo-planar/resultados/reales/e1/06_correlacion_cruzada.png

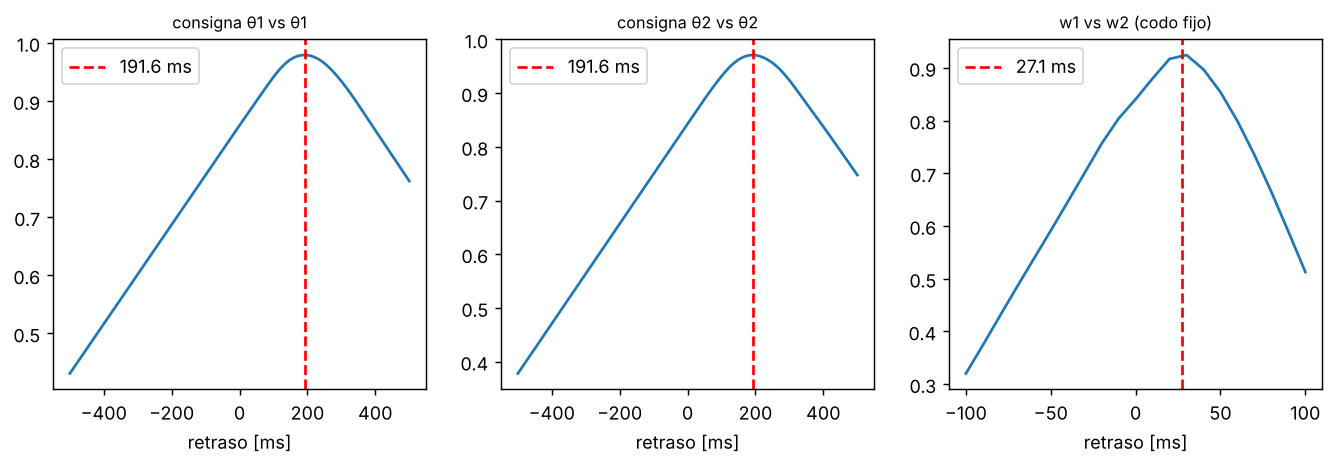
resultados/reales/e1/06_correlacion_cruzada.png
