celytiorja/lab-Brazo-planar/resultados/reales/e1/07_dinamico_comparacion.png

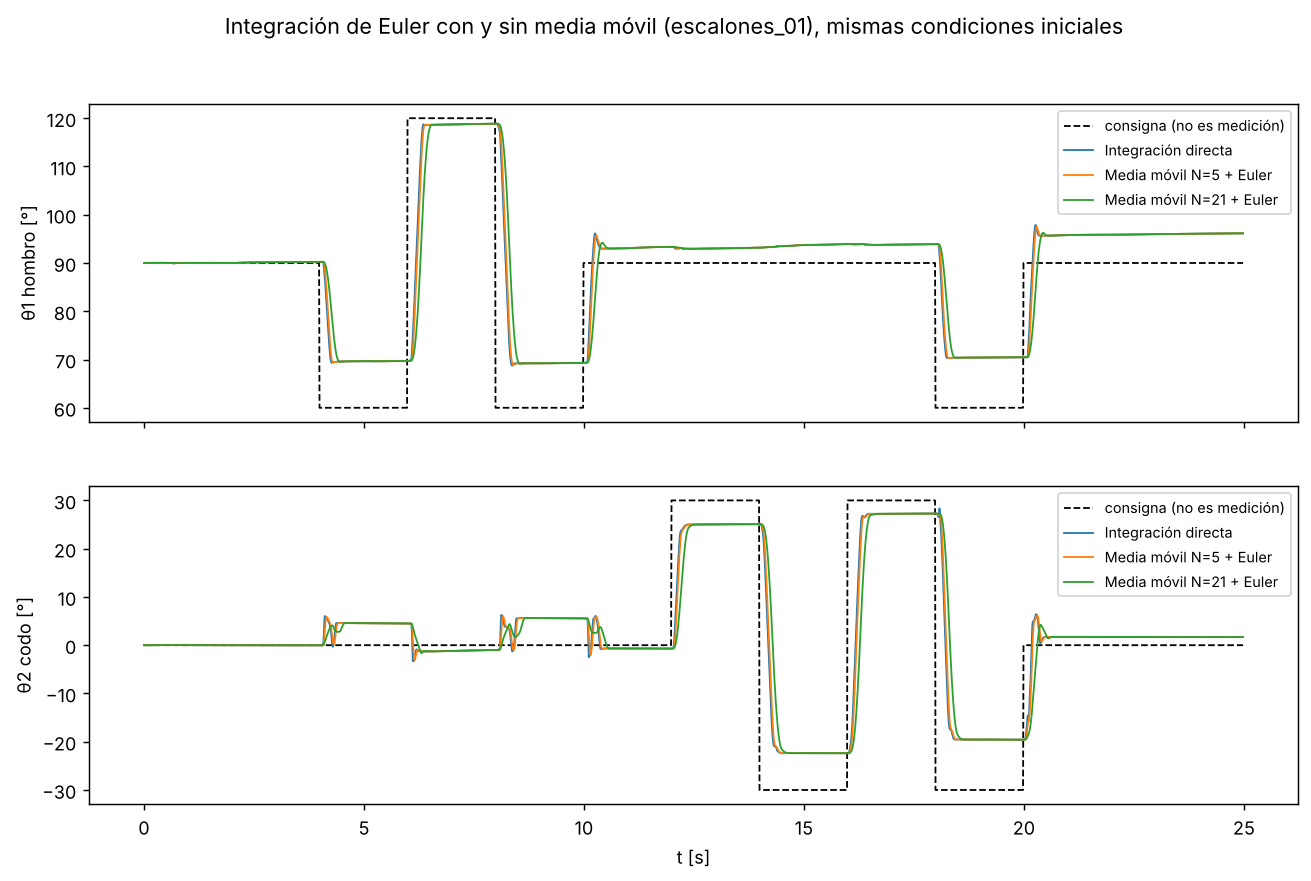
resultados/reales/e1/07_dinamico_comparacion.png
