celytiorja/lab-Brazo-planar/resultados/reales/e1/08_zoom_retraso.png

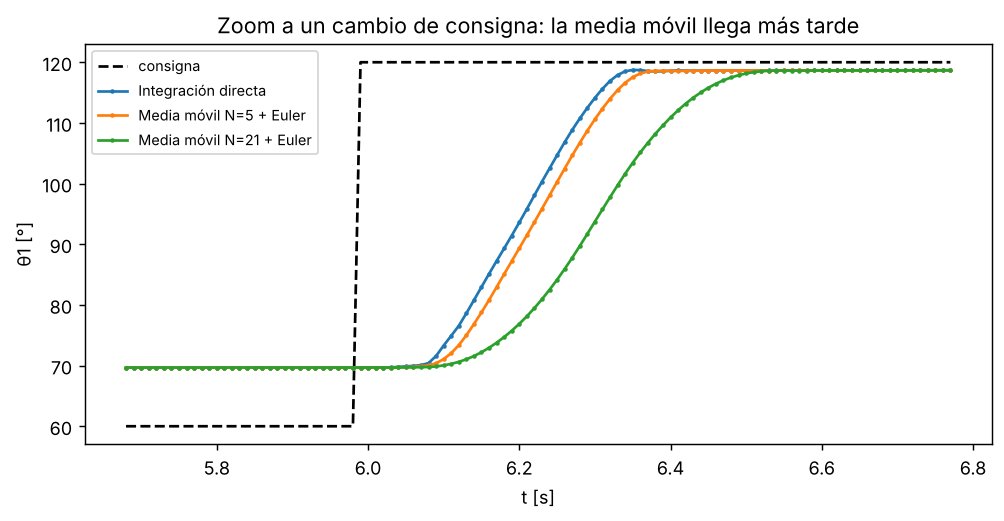
resultados/reales/e1/08_zoom_retraso.png
