celytiorja/lab-Brazo-planar/resultados/reales/e1/10_sensibilidad_ventana.png

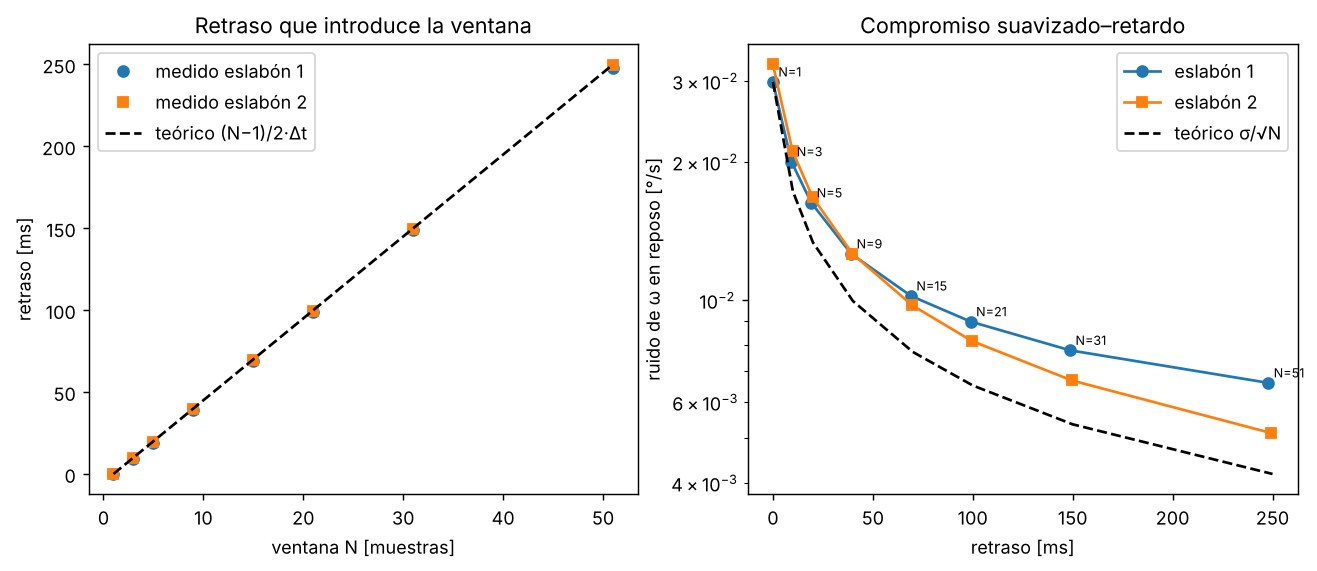
resultados/reales/e1/10_sensibilidad_ventana.png
