celytiorja/lab-Brazo-planar/resultados/reales/e1/11_correlacion_canales.png

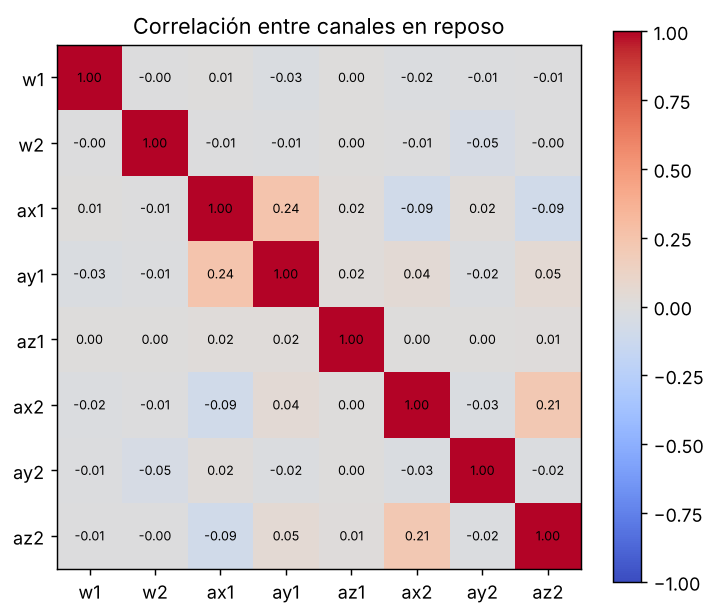
resultados/reales/e1/11_correlacion_canales.png
