celytiorja/lab-Brazo-planar/resultados/reales/e2/10_ajuste_configuraciones_Q_seno_lento_01.png

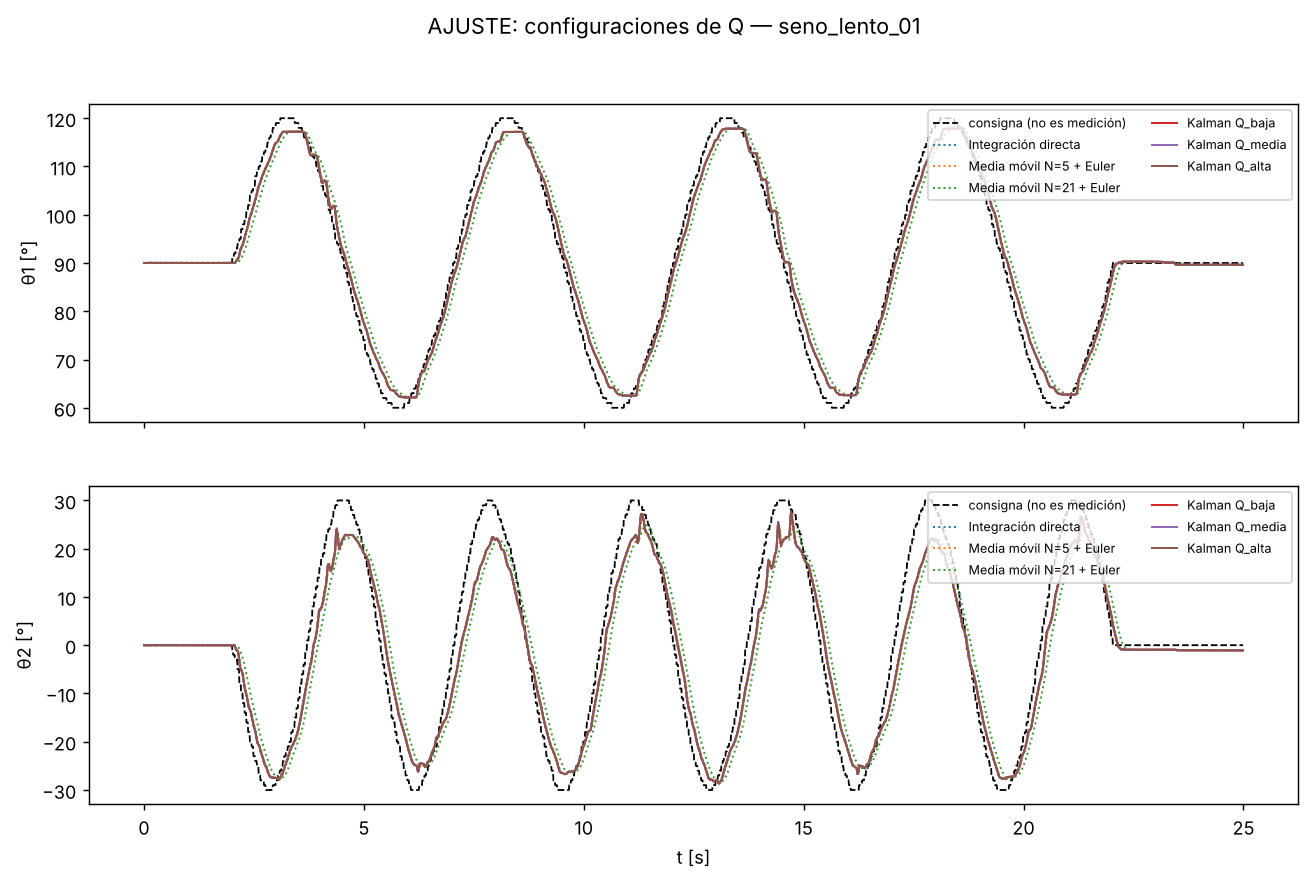
resultados/reales/e2/10_ajuste_configuraciones_Q_seno_lento_01.png
