celytiorja/lab-Brazo-planar/resultados/reales/e2/11_innovaciones_nis.png

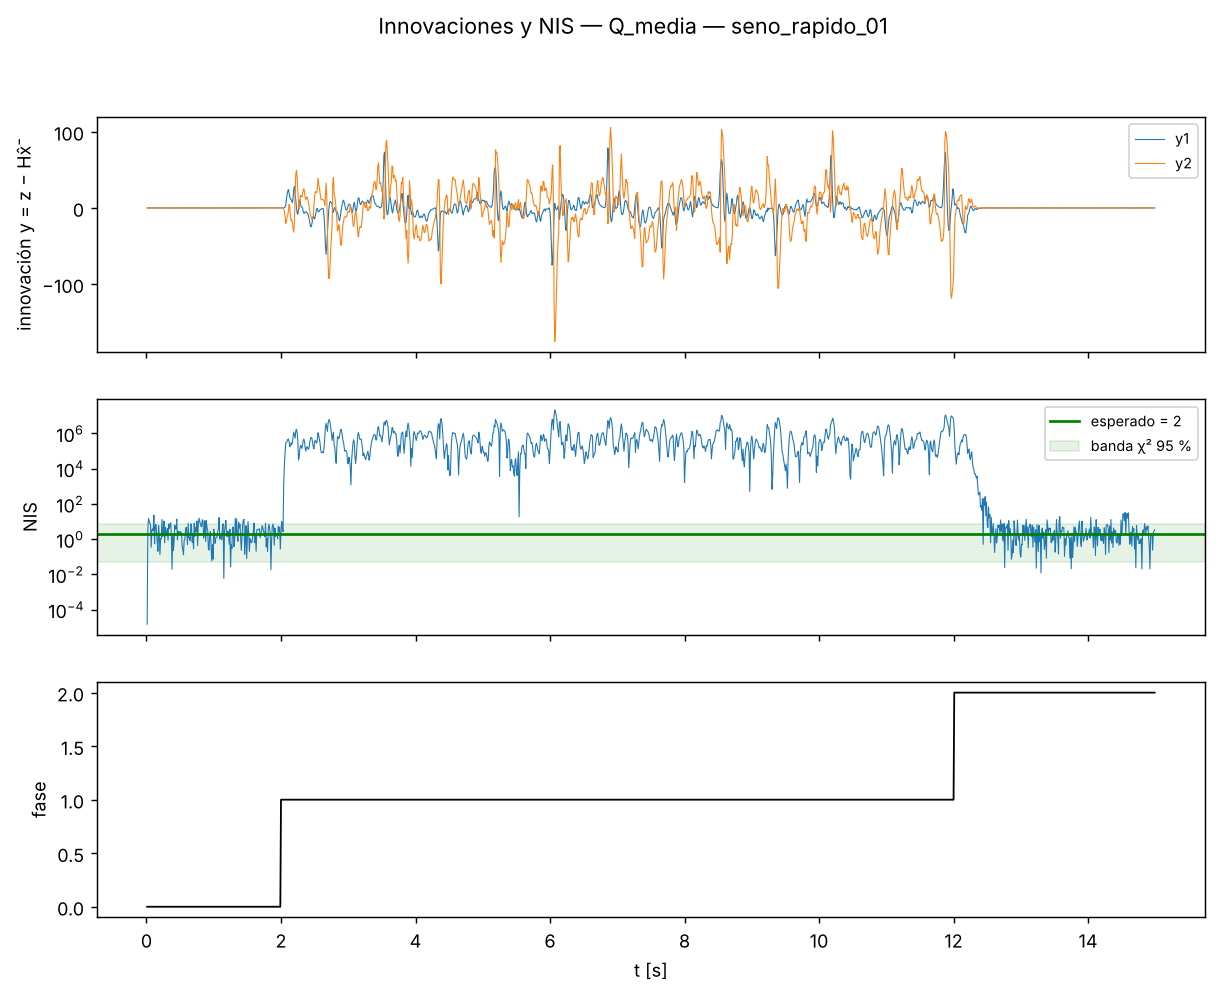
resultados/reales/e2/11_innovaciones_nis.png
