celytiorja/lab-Brazo-planar/resultados/reales/e2/15_validacion_comparacion_escalones_03.png

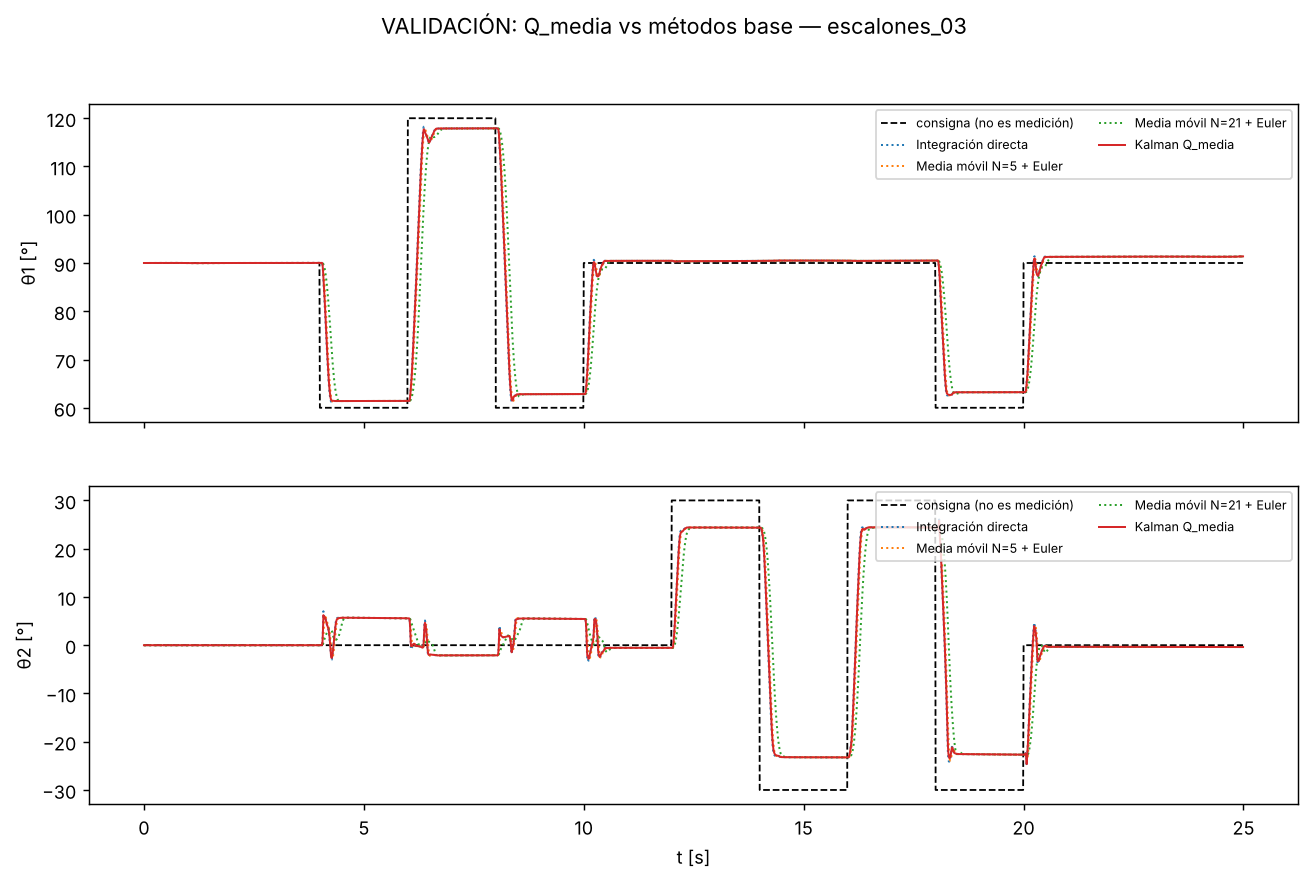
resultados/reales/e2/15_validacion_comparacion_escalones_03.png
