celytiorja/lab-Brazo-planar/resultados/reales/e2/15_validacion_comparacion_seno_lento_02.png

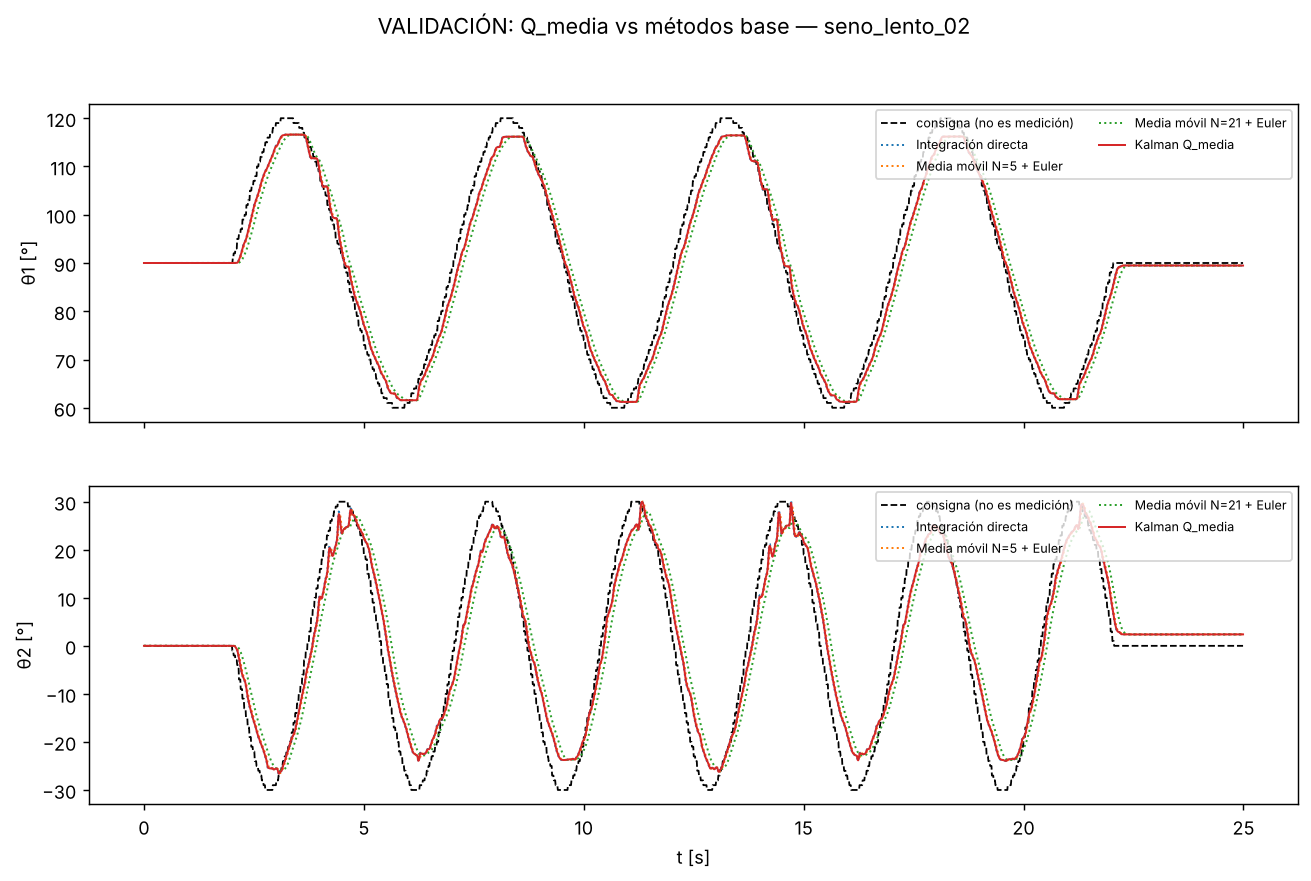
resultados/reales/e2/15_validacion_comparacion_seno_lento_02.png
