celytiorja/lab-Brazo-planar/resultados/reales/teleop/20_teleop_sesion_02.png

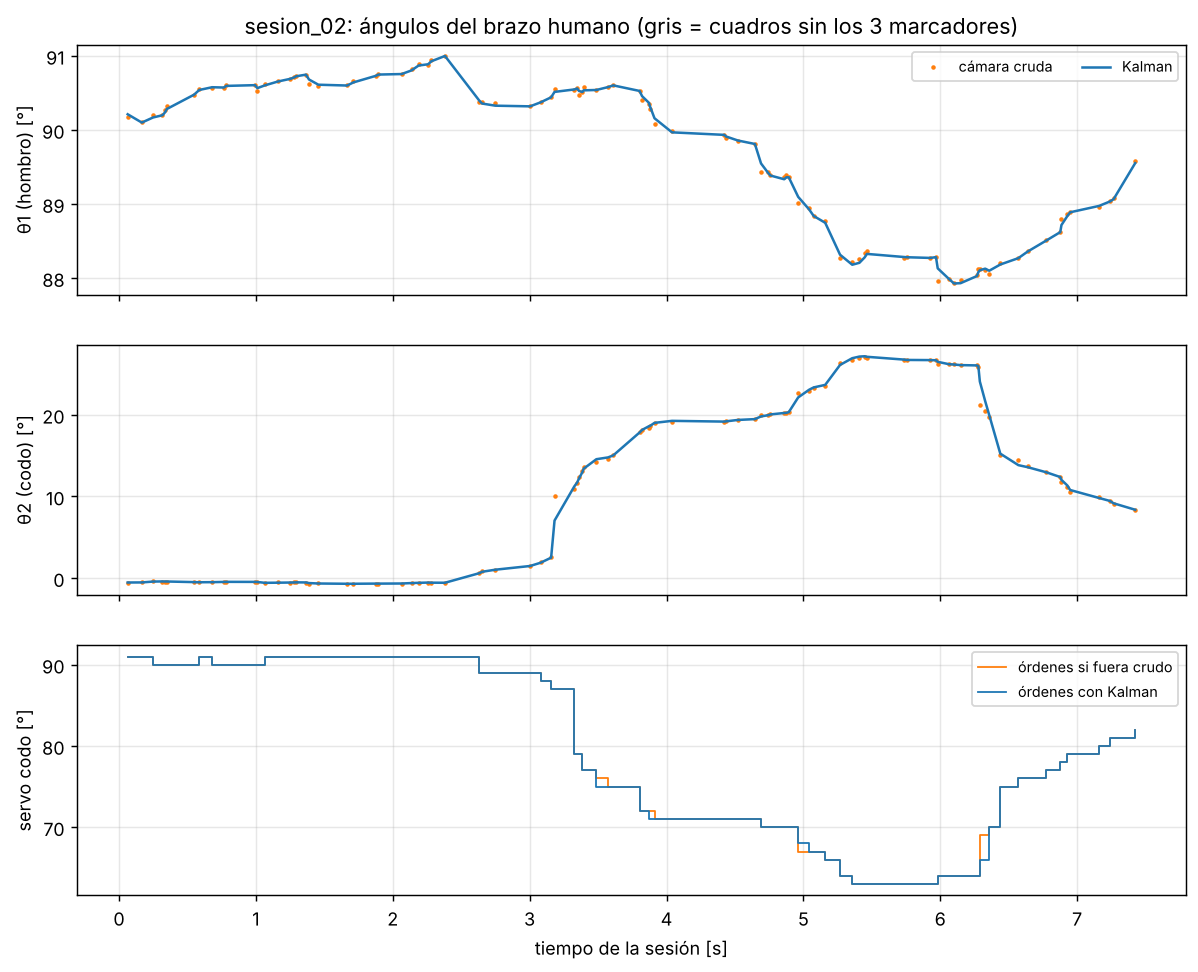
resultados/reales/teleop/20_teleop_sesion_02.png
