celytiorja/lab-Brazo-planar/resultados/reales/teleop/21_robot_sesion_01.png

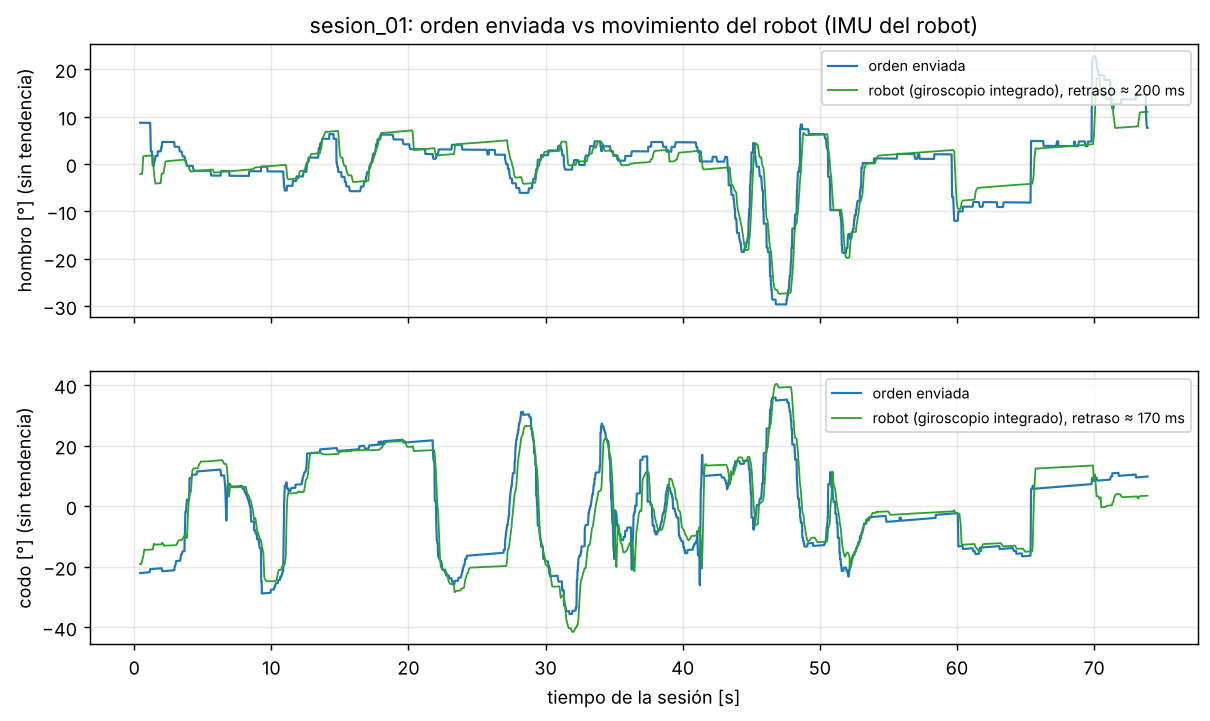
resultados/reales/teleop/21_robot_sesion_01.png
