celytiorja/lab-Brazo-planar/resultados/sinteticos/e1/01_reposo_senales_histogramas.png

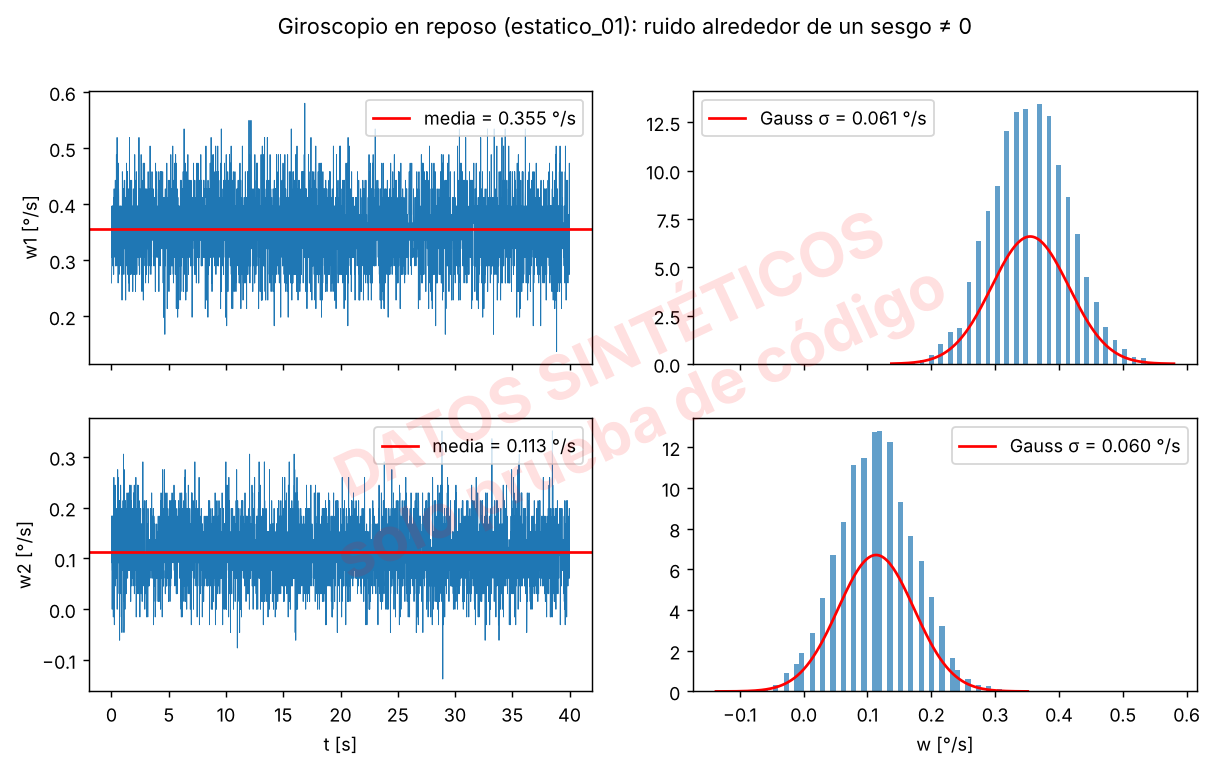
resultados/sinteticos/e1/01_reposo_senales_histogramas.png
