celytiorja/lab-Brazo-planar/resultados/sinteticos/e1/03_matriz_R.png

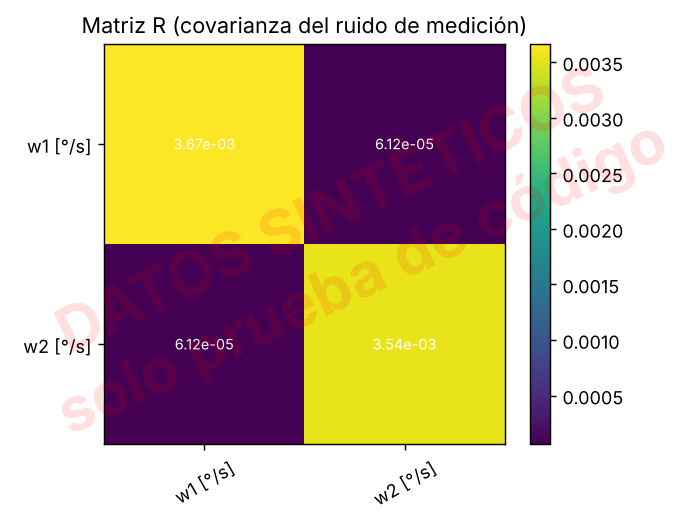
resultados/sinteticos/e1/03_matriz_R.png
