celytiorja/lab-Brazo-planar/resultados/sinteticos/e1/04_histograma_dt.png

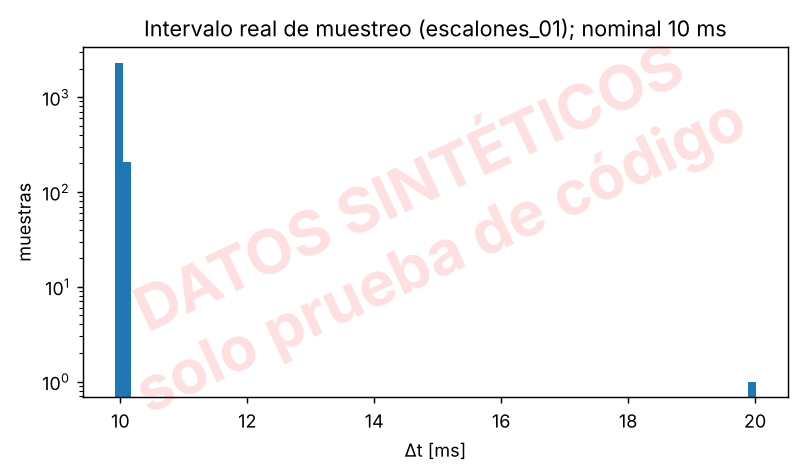
resultados/sinteticos/e1/04_histograma_dt.png
