celytiorja/lab-Brazo-planar/resultados/sinteticos/e1/05_deriva_en_reposo.png

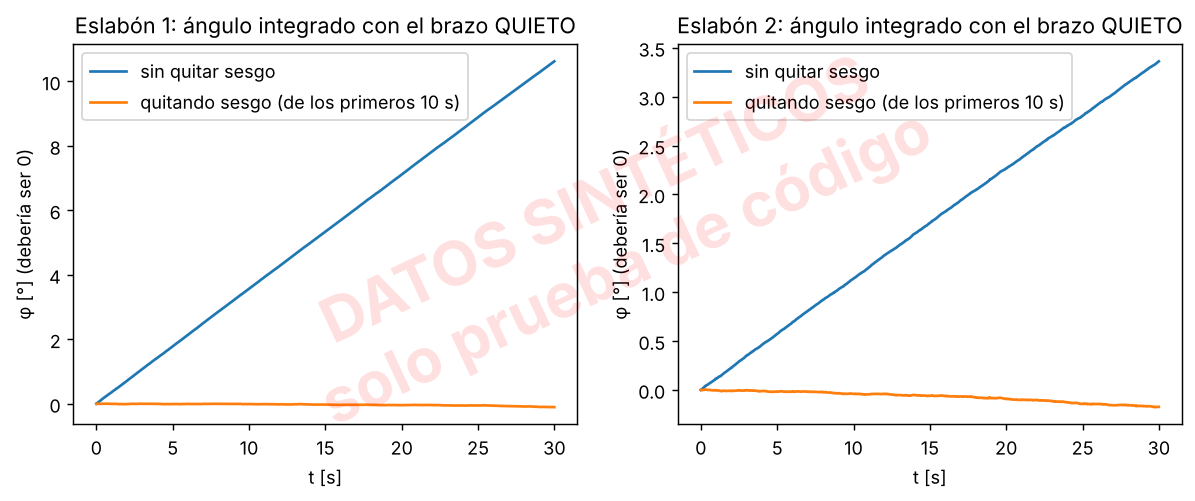
resultados/sinteticos/e1/05_deriva_en_reposo.png
