celytiorja/lab-Brazo-planar/resultados/sinteticos/e1/06_correlacion_cruzada.png

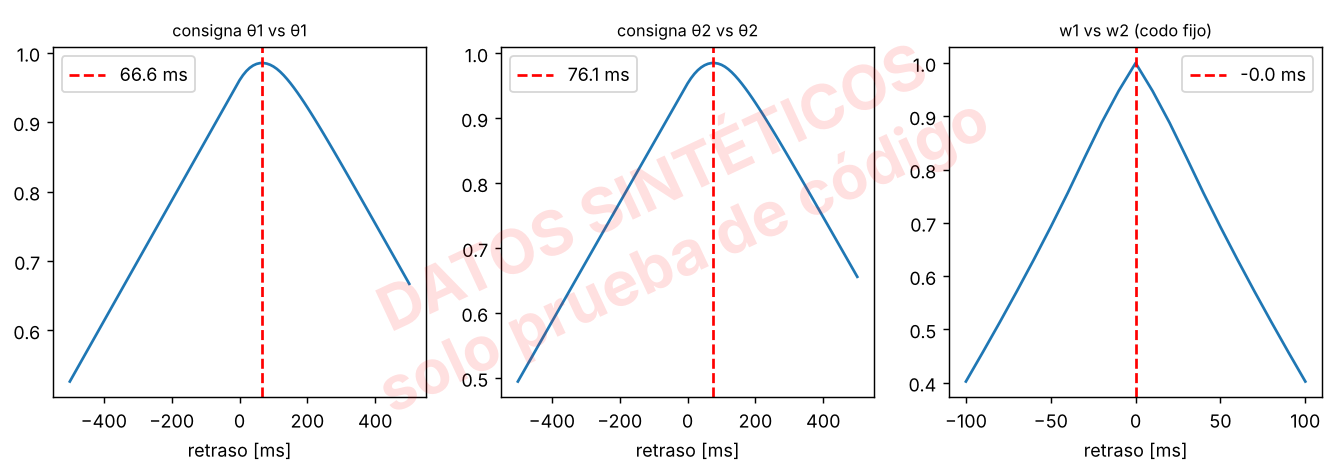
resultados/sinteticos/e1/06_correlacion_cruzada.png
