celytiorja/lab-Brazo-planar/resultados/sinteticos/e1/07_dinamico_comparacion.png

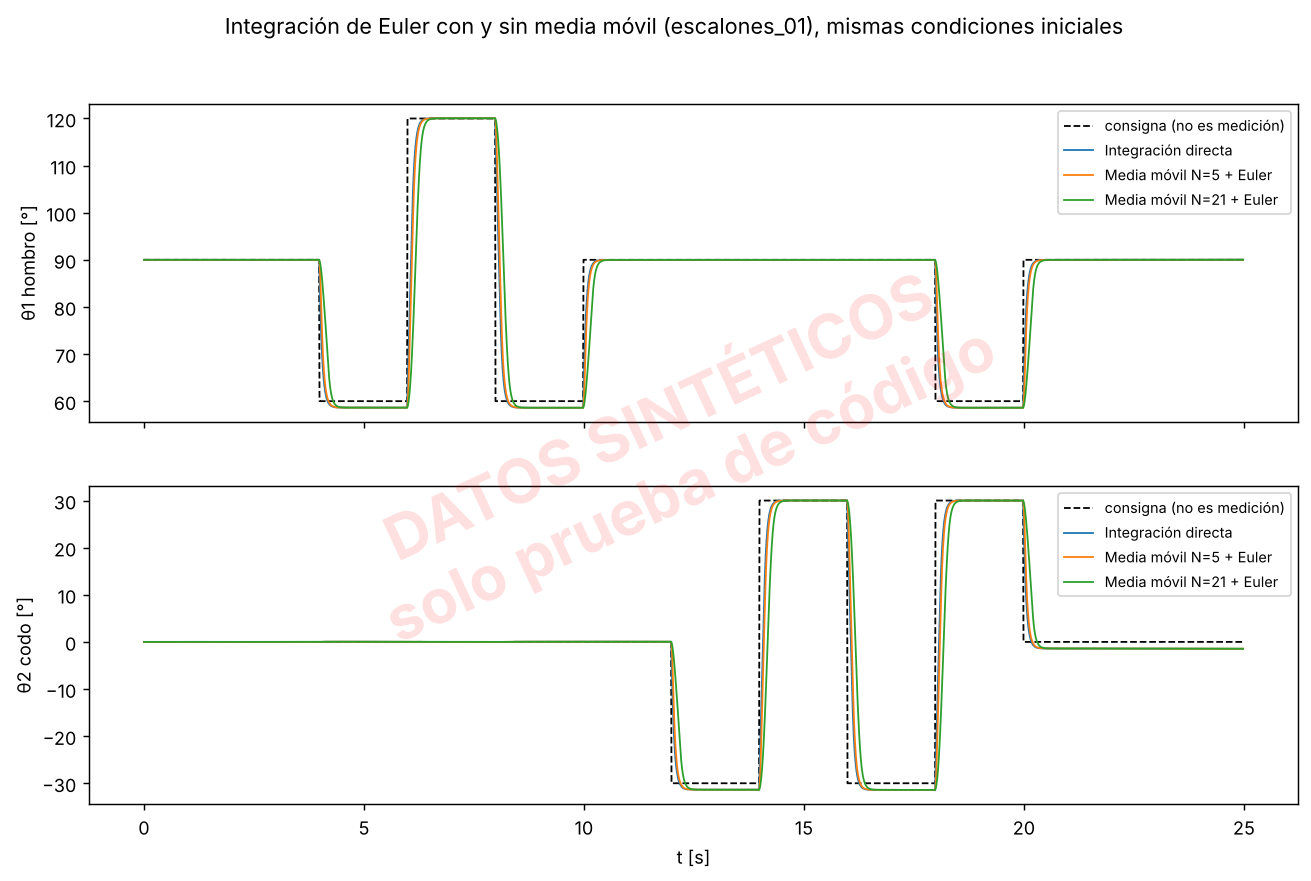
resultados/sinteticos/e1/07_dinamico_comparacion.png
