celytiorja/lab-Brazo-planar/resultados/sinteticos/e1/08_zoom_retraso.png

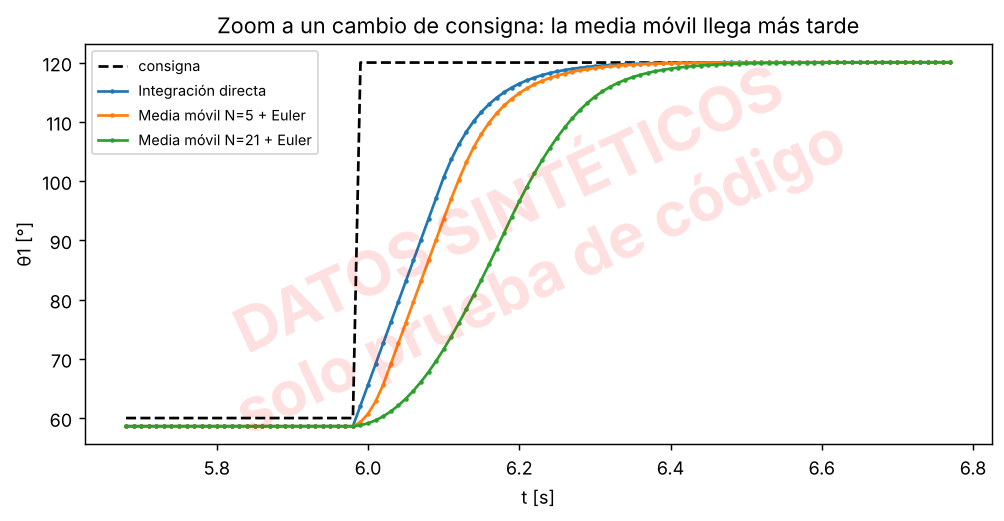
resultados/sinteticos/e1/08_zoom_retraso.png
