celytiorja/lab-Brazo-planar/resultados/sinteticos/e1/09_verificacion_cinematica.png

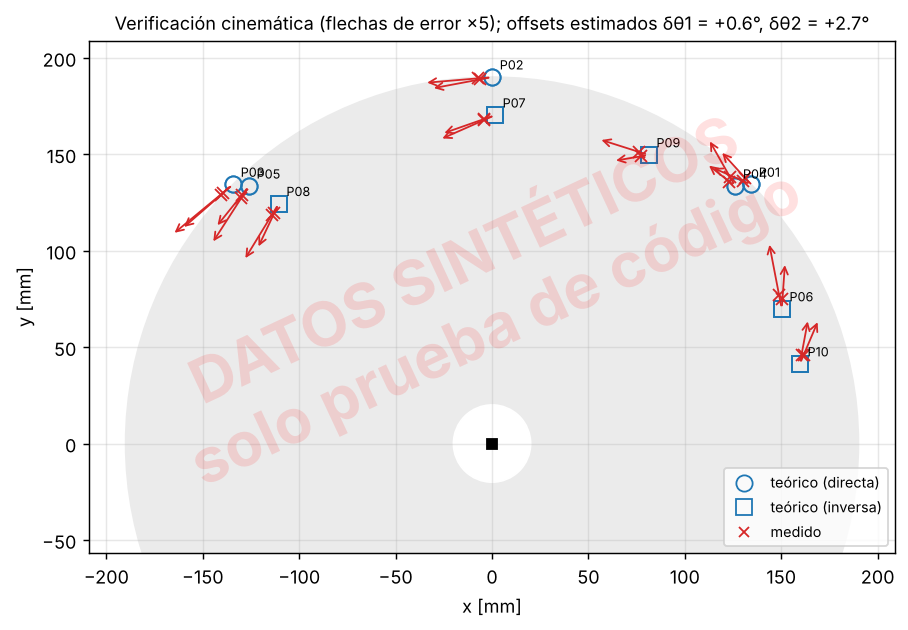
resultados/sinteticos/e1/09_verificacion_cinematica.png
