celytiorja/lab-Brazo-planar/resultados/sinteticos/e1/10_sensibilidad_ventana.png

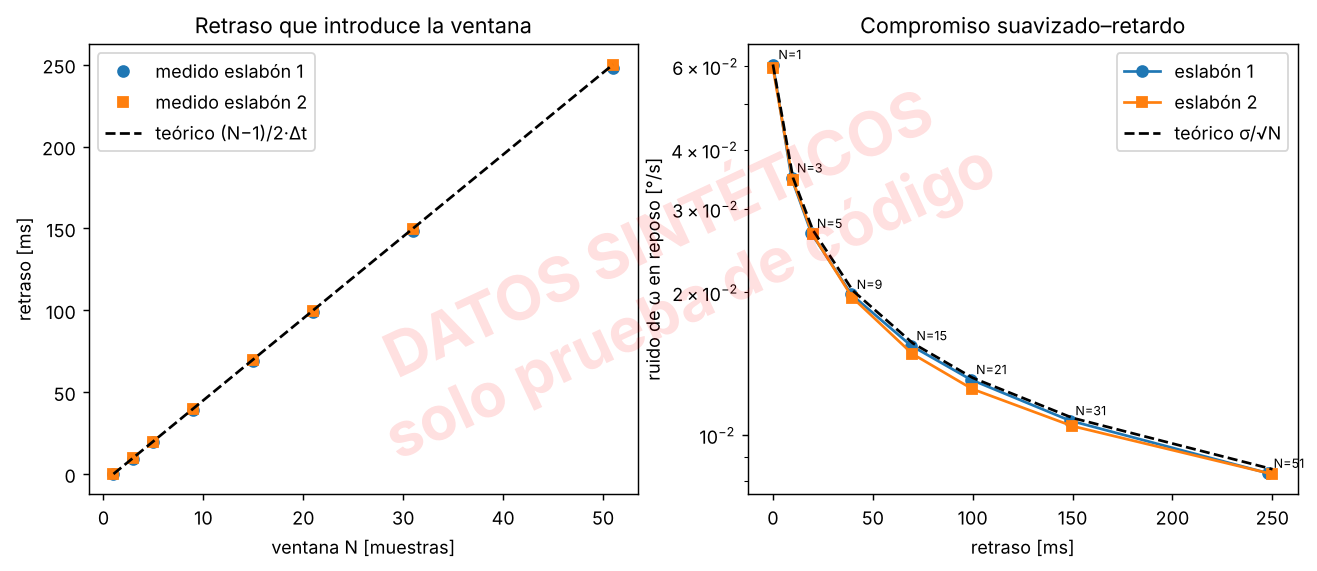
resultados/sinteticos/e1/10_sensibilidad_ventana.png
