celytiorja/lab-Brazo-planar/resultados/sinteticos/e1/11_correlacion_canales.png

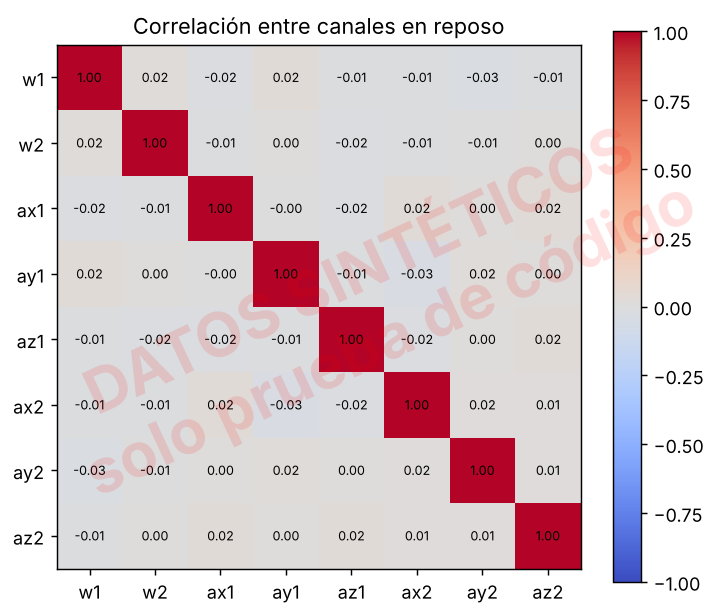
resultados/sinteticos/e1/11_correlacion_canales.png
