celytiorja/lab-Brazo-planar/resultados/sinteticos/e2/10_ajuste_configuraciones_Q_escalones_01.png

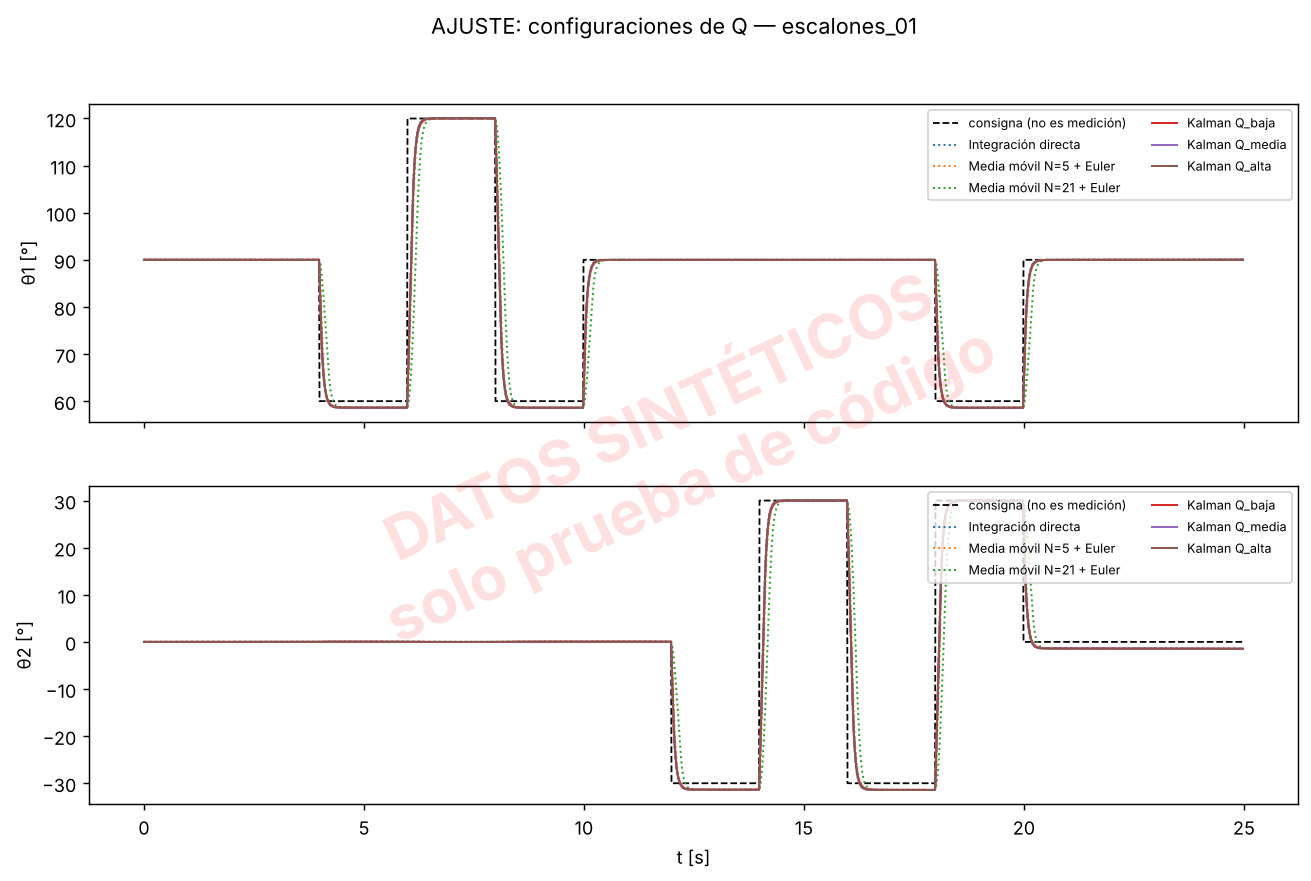
resultados/sinteticos/e2/10_ajuste_configuraciones_Q_escalones_01.png
