celytiorja/lab-Brazo-planar/resultados/sinteticos/e2/10_ajuste_configuraciones_Q_seno_lento_01.png

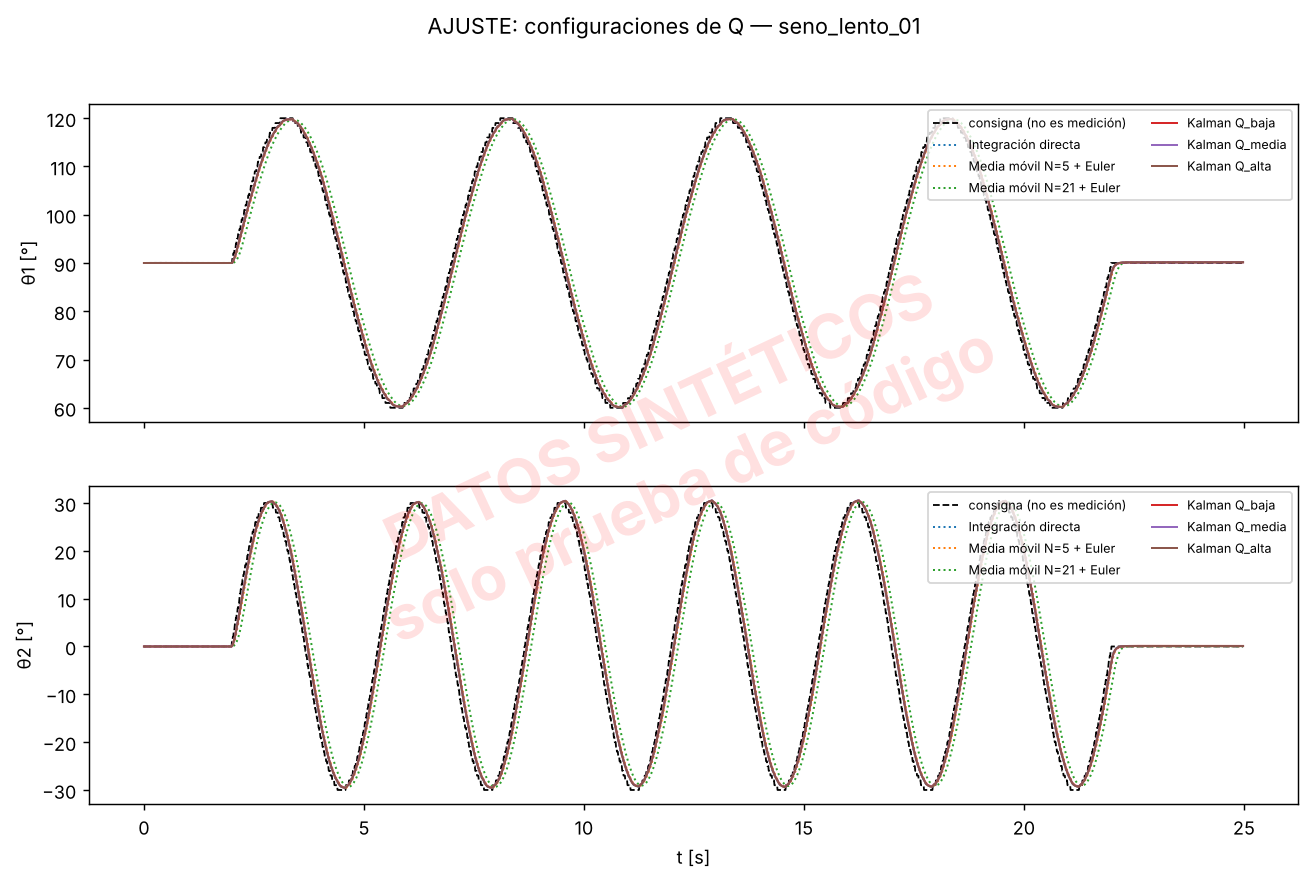
resultados/sinteticos/e2/10_ajuste_configuraciones_Q_seno_lento_01.png
