celytiorja/lab-Brazo-planar/resultados/sinteticos/e2/11_innovaciones_nis.png

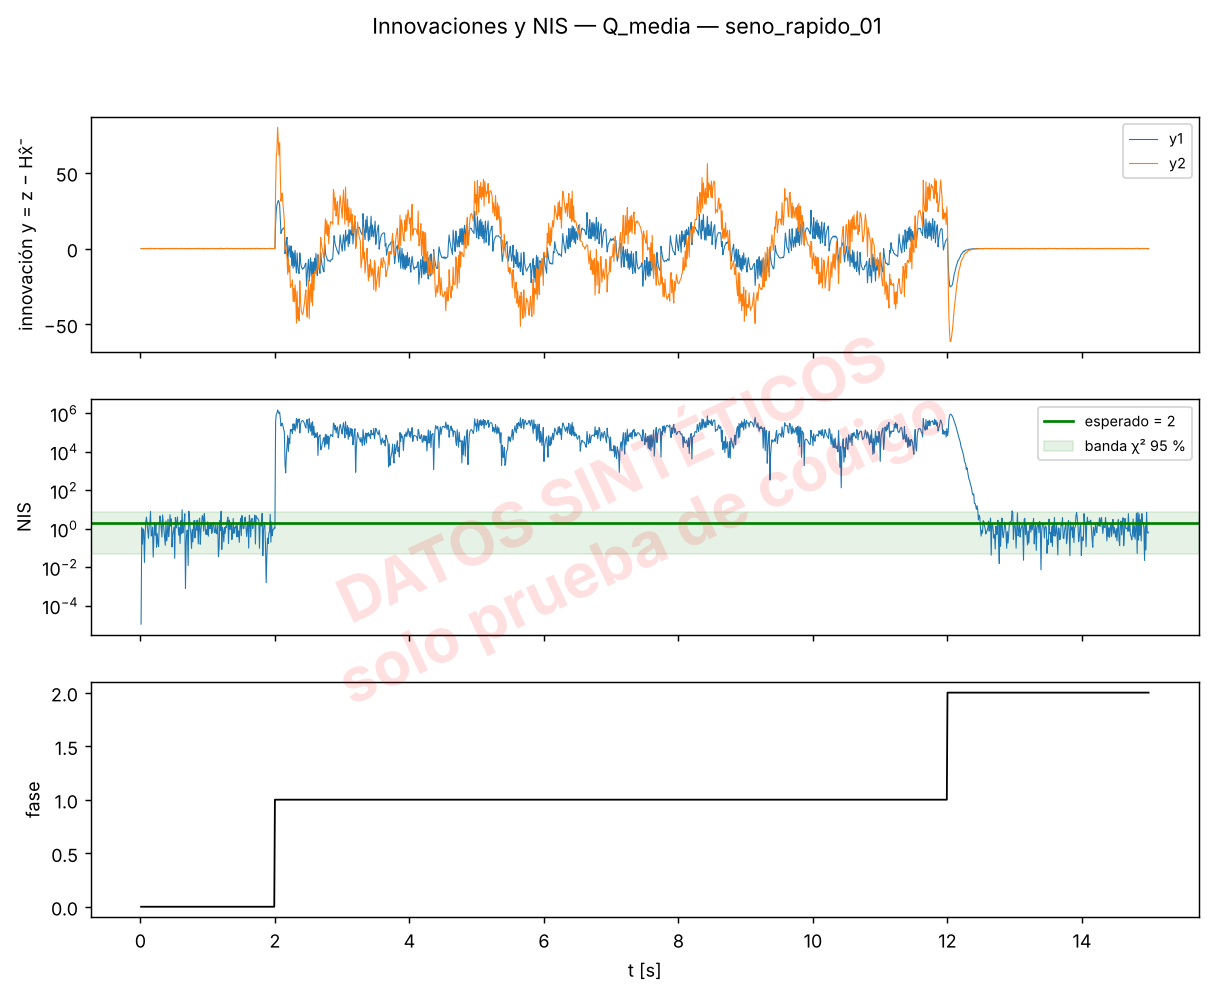
resultados/sinteticos/e2/11_innovaciones_nis.png
