celytiorja/lab-Brazo-planar/resultados/sinteticos/e2/13_aceleracion_angular.png

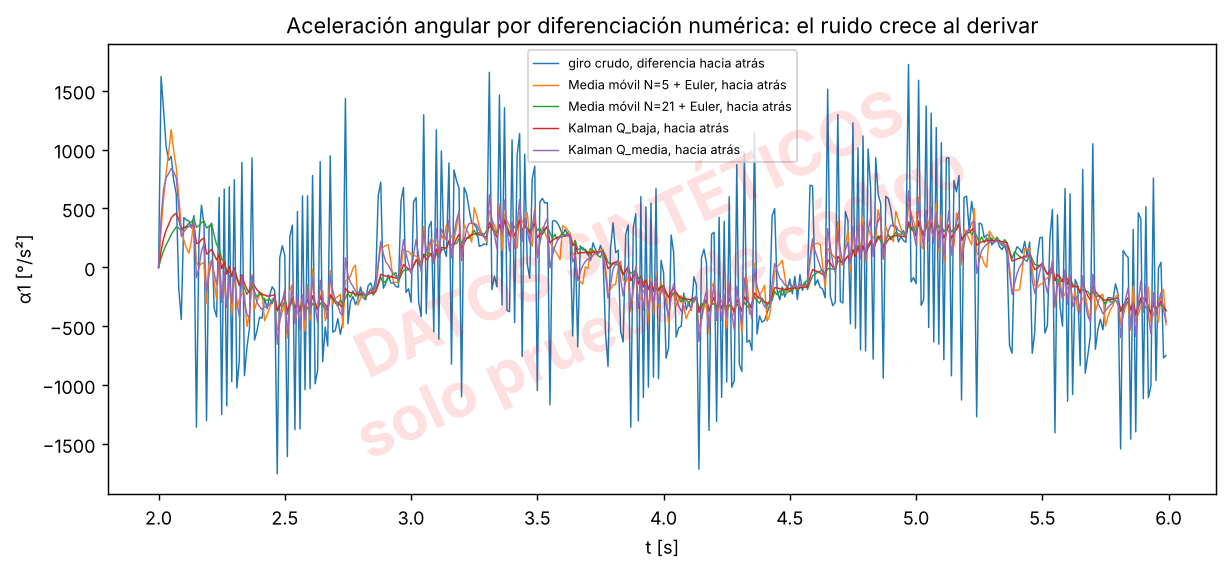
resultados/sinteticos/e2/13_aceleracion_angular.png
