celytiorja/lab-Brazo-planar/resultados/sinteticos/e2/14_compromiso_Q_R.png

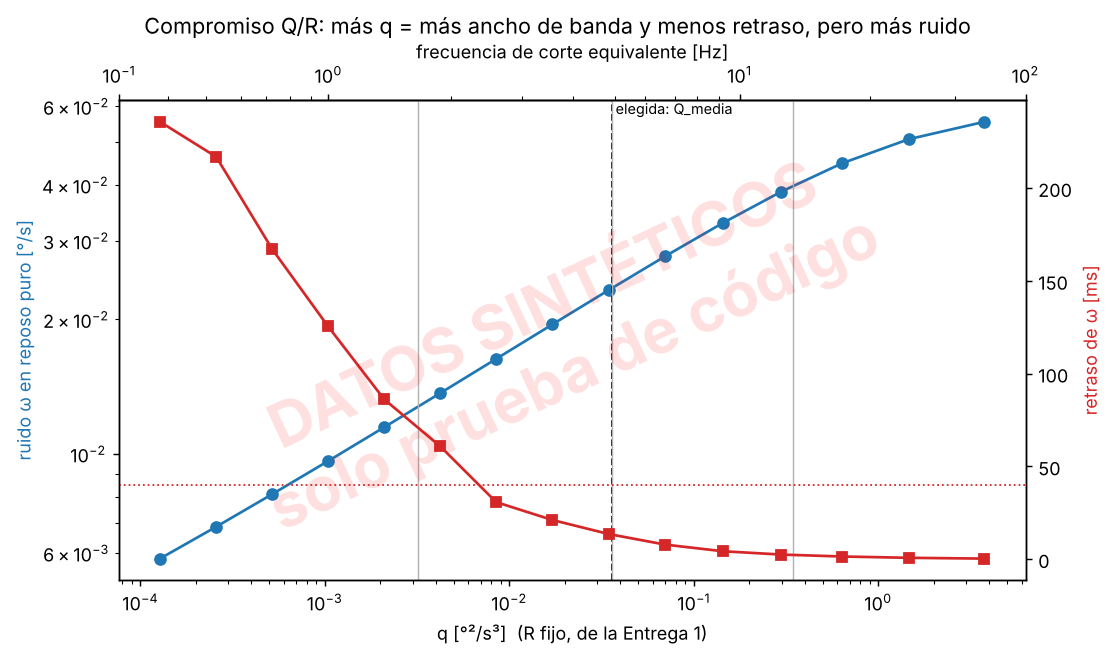
resultados/sinteticos/e2/14_compromiso_Q_R.png
