celytiorja/lab-Brazo-planar/resultados/sinteticos/teleop/21_robot_sesion_02.png

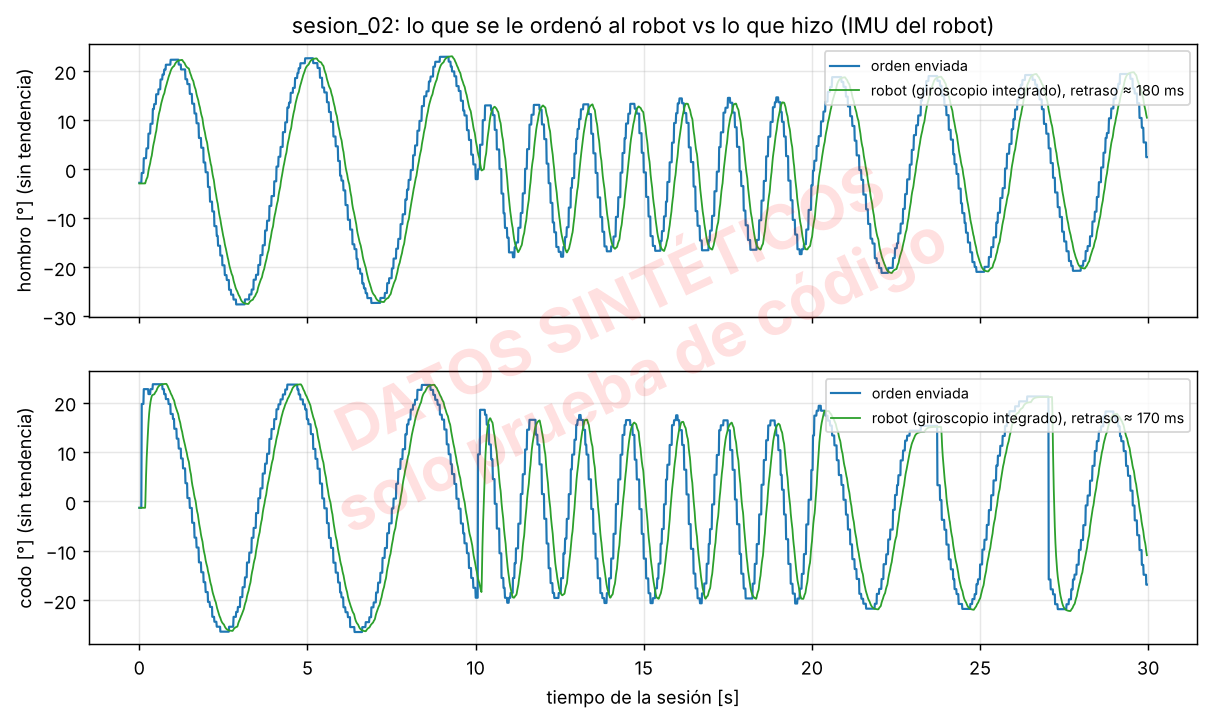
resultados/sinteticos/teleop/21_robot_sesion_02.png
