celytiorja/lab-Brazo-planar/(commit log)

2026-10-25 Estructura inicial: cinemática, simulador, prueba de hardware y guías
    - Cinemática directa e inversa (python/cinematica.py) con pruebas automáticas
    - Simulador interactivo para practicar directa/inversa
    - Sketch de Arduino para verificar servos e IMU (I2C 0x68/0x69)
    - Documentación: Git para principiantes, teoría de cinemática y conexiones
    Claude-Session: https://claude.ai/code/session_01CHM2SqddESE2CQYJ4BqBiV
2026-10-26 Simulador: muestra las dos soluciones (codo arriba/abajo) a la vez
    Antes, cambiar "codo arriba/abajo" no movía nada hasta el siguiente clic.
    Ahora el brazo azul es la solución actual, el gris punteado la otra, y la
    línea roja hombro-punta es el espejo entre ambas. Los botones cambian de
    solución al instante sin mover la punta, y avisan si queda fuera de los
    límites de los servos.
    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
2026-10-26 Agrega prueba solo de servos (sin IMU)
    Sketch corto para mover hombro y codo desde el Monitor Serie (h/c <ángulo>)
    y hacer un barrido lento. Explica cómo el ancho de pulso fija el ángulo.
    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
2026-10-26 Nota: ubicación del repo en el PC del usuario y entorno virtual
    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
2026-10-26 Prueba de servos: acepta varias órdenes por línea ("h 45, c 90")
    Antes solo se leía la primera orden de cada línea y el resto se ignoraba.
    Ahora la línea se corta en cada coma y cada trozo se procesa por separado.
    También acepta las órdenes sin espacio ("h45").
    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
2026-10-26 Interfaz gráfica para mover el brazo real desde el PC
    - interfaz.py: el simulador + conexión serie con el ESP32 (protocolo de
    prueba_servos). Envía como máximo una orden cada 40 ms y muestra lo que
    responde el ESP32.
    - servos.py: traducción θ del modelo <-> ángulo del servo con calibración
    OFFSET/SIGNO; los límites de θ se deducen de ella (parametros.py).
    - conexion.py: abrir puerto, enviar órdenes y leer líneas sin bloquear.
    - simulador.py: el dibujo pasa a la clase VistaBrazo para reutilizarlo.
    - docs/03_interfaz.md: recorrido de una orden, calibración y errores típicos.
    - Pruebas de calibración y del texto enviado/recibido.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
    [conexion.py, interfaz.py, parametros.py, servos.py, simulador.py, test_servos_conexion.py]
2026-10-26 Medidas reales de L1 (105 mm) y L2 (85 mm)
2026-10-26 Notas: estado al cierre de la sesión y pasos pendientes
    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
2026-10-27 Entregas 1 y 2: adquisición, caracterización IMU y filtro de Kalman
    - firmware/adquisicion: 100 Hz con timestamps, perfiles repetibles, 460800 baud.
    - Análisis E1: estadística en reposo, matriz R, temporización, correlación
    cruzada, deriva, Euler con media móvil (N=5, 21) y tabla de métricas.
    - Análisis E2: Kalman propio (estado [φ1, ω1, φ2, ω2], Δt_k real, Joseph),
    tres Q razonadas por frecuencia de corte a partir de R, ajuste/validación
    separados, NIS, chequeo de P, ganancia K, compromiso Q/R y aceleración
    angular numérica.
    - Datos SINTÉTICOS (marcados) para probar la cadena sin IMU, y sus resultados.
    - docs/SUSTENTACION.md: guía rápida de qué mostrar.
    Co-Auth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
    [aceleracion_angular.csv, compromiso_Q_R.csv, consistencia_kalman.csv, correlacion_cruzada.csv, escalones_01.csv, escalones_01_verdad.csv, escalones_02.csv, escalones_02_verdad.csv]
2026-11-01 Interfaz con IMU en vivo: visualización, grabación y teleoperación
    - interfaz_imu.py: brazo con consigna y estimaciones (directa, media móvil,
    Kalman), gráficas de ω y θ de los últimos 10 s, calibración del sesgo,
    grabación de reposo/perfiles/libre y elección de la fuente que mueve el
    brazo (sliders o estimación), con tiempos de cómputo y muestreo real.
    - tiempo_real.py: mismos estimadores que el análisis, muestra a muestra.
    - grabador.py: CSV crudo + JSON de configuración y manifiesto automático
    (ajuste = repetición 01, validación = repetición 02).
    - conexion.py: velocidad configurable y envío de órdenes de texto.
    - Pruebas del Kalman, media móvil, Q desde f_c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
2026-11-01 Entrega 1 completa: verificación cinemática, validación de datos y análisis N4/N5
    - verificacion_cinematica.py: plantilla de 10 puntos (directa e inversa, 2
    repeticiones), error por punto, RMSE, repetibilidad, error esperado por la
    resolución de 1° y offsets de cada articulación por mínimos cuadrados.
    - validar_datos.py: integridad automática de los CSV crudos (columnas, NaN,
    seq, timestamps con desborde, fs ±2 %, jitter, duración, saturación, IMU
    congelada, perfiles/fases); analisis_e1 la ejecuta primero.
    - analisis_e1_extra.py: sensibilidad a la ventana (N = 1…51) con teoría,
    variantes de sesgo, Δt_k real vs 1/fs, ruido de alta frecuencia vs deriva,
    estacionarie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
    [00_validacion_datos.csv, correlacion_cruzada.csv, degradacion_movimiento.csv, dt_real_vs_nominal.csv, estructura_R.csv, metricas_e2_ajuste.csv, metricas_e2_validacion.csv, metricas_e2_validacion_resumen.csv]
2026-11-01 Notas: estrategia de enseñanza y registro de comprensión
    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
2026-11-01 Kalman paso a paso: versión de 1 variable con todos los números, para aprender
    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
2026-11-01 Corrige: la interfaz con IMU no abría ventana
    reporte.py forzaba matplotlib.use("Agg") al importarse, y la interfaz lo
    importa (vía tiempo_real y grabador): la ventana nunca se mostraba. Ahora
    solo los scripts de análisis eligen "Agg".
    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
    [analisis_e1.py, analisis_e1_extra.py, analisis_e2.py, reporte.py, verificacion_cinematica.py]
2026-11-01 Interfaz IMU: diagnóstico en la terminal y reloj a prueba de errores
    - Cada mensaje se imprime también en la terminal.
    - Contador de líneas recibidas y aviso de la primera muestra.
    - Si algo falla dentro del ciclo, se muestra el error y la ventana sigue viva.
    - "Calibrar" explica si falta conectar o si aún no llegan datos.
    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
    [interfaz_imu.py]
2026-11-01 Notas: firmware e interfaz con IMU funcionando en el PC del usuario
    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
2026-11-01 Interfaz IMU ~12× más rápida: blitting y dibujo separado de la lectura
    Medido: redibujar la figura completa tardaba ~230 ms y se pedía cada 50 ms,
    por eso todo se trababa (procesar las muestras solo toma ~1.4 ms).
    - blit.py: el fondo se dibuja una vez; en cada cuadro solo se pintan las
    líneas, el brazo, los sliders y los textos que cambian (~34 ms).
    - Eje de tiempo fijo ("segundos atrás") y escala vertical que se ajusta
    como mucho una vez por segundo y solo si hace falta.
    - El puerto se lee y las órdenes se envían cada 40 ms; se dibuja cada 80 ms.
    - Se grafica 1 de cada 3 muestras.
    - VistaBrazo admite redibujar=False y expone sus artistas dinámicos.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
2026-11-02 Primeras capturas reales: 3 perfiles
    [escalones_01.csv, estatico_01.csv, seno_lento_01.csv, seno_rapido_01.csv]
2026-11-02 Firmware 1.1: muestreo en núcleo propio; análisis descarta el arranque del perfil
    Encontrado con las primeras capturas reales:
    - servo.write() bloqueaba ~15 ms y en los perfiles seno el muestreo bajó a
    ~55 Hz (Δt hasta 40 ms). Ahora la lectura de las IMU es una tarea de
    FreeRTOS en el núcleo 0 con período fijo; los servos se escriben como
    máximo cada 20 ms desde loop() (núcleo 1). Mismo formato de datos.
    - Al empezar un perfil el servo viene de la posición anterior (105°, 94°) y
    se mueve ~0.5 s dentro del "reposo inicial": eso ensuciaba el sesgo y la
    condición inicial (error estacionario 49° -> 5.8° al corregirlo).
    datos_imu.cargar descarta el primer 1 s de la fase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
    [seno_lento_01.csv, seno_rapido_01.csv]
2026-11-02 Interfaz IMU: botón "Ir a posición de inicio" y estimaciones que arrancan en la consigna
    - Antes de calibrar, las estimaciones partían de 0° y se veía un desfase de
    ~90° con la consigna; ahora arrancan en la pose de la consigna.
    - Nuevo botón para llevar los servos a (90°, 90°) antes de calibrar/grabar.
    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
2026-11-02 Capturas reales completas (firmware 1.1) y CODO_SIGNO = -1
    [escalones_02.csv, escalones_03.csv, estatico_02.csv, seno_lento_01.csv, seno_rapido_01.csv]
2026-11-02 Firmware 1.2: el I2C se inicia en el núcleo de muestreo
    Las capturas seno con fw 1.1 aún mostraban lecturas I2C de hasta 39 ms
    (t2 − t1) solo durante el movimiento, con 96.6 Hz y 89 muestras perdidas.
    Wire.begin() instala la interrupción en el núcleo que lo llama; al hacerlo
    en setup() quedaba en el núcleo 1, el de los servos. Ahora la tarea de
    muestreo (núcleo 0) inicia el I2C y las IMU; setup() espera a que terminen
    para imprimir la configuración.
    seno_lento_01 y seno_rapido_01 (fw 1.1) pasan a descartados/ con su análisis.
    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
    [seno_lento_01_fw1.1.csv, seno_rapido_01_fw1.1.csv]
2026-11-02 Notas: estado de capturas reales y firmware 1.2
    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
2026-11-02 Capturas: escalones_04, seno_lento_02, seno_rapido_02
    [escalones_04.csv, estatico_03.csv, seno_lento_02.csv, seno_rapido_02.csv]
2026-11-02 Senos con firmware 1.1 (repetición) a descartados; encabezado de tablas robusto
    - seno_lento_02 y seno_rapido_02 se grabaron con fw 1.1 y repiten el mismo
    patrón (lecturas I2C de ~39 ms, 96–99 Hz). Pasan a descartados/ para que
    las próximas capturas con fw 1.2 se llamen _01 (ajuste) y _02 (validación).
    - reporte.encabezado acepta manifiestos fuera del proyecto.
    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
    [seno_lento_02_fw1.1.csv, seno_rapido_02_fw1.1.csv]
2026-11-02 Senos con firmware 1.2: ajuste y validación
    [escalones_05.csv, seno_lento_01.csv, seno_lento_02.csv, seno_rapido_01.csv, seno_rapido_02.csv]
2026-11-02 Resultados REALES de las Entregas 1 y 2; subida automática de capturas
    Datos: 12 capturas reales a 100 Hz sin pérdidas (firmware 1.2 en los senos).
    Selección objetiva de datos (manifiesto automático):
    - Reposo para R: el primero estacionario (Levene p > 0.05) -> estatico_03
    (los otros dos tenían movimientos: p ≈ 1e-36, ρ w1–w2 ≈ 0.85).
    - Perfiles: solo repeticiones que pasan validar_datos, con un chequeo nuevo
    "el brazo medido sigue a la consigna"; escalones_02 rechazada (el hombro no
    se movió: amplitud medida/consigna = 0.47).
    Análisis:
    - E2 mide el ruido de cada método en el REPOSO PURO (antes se mezclaba con la
    cola del movimiento en los reposos de los perfiles) y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
    [00_validacion_datos.csv, aceleracion_angular.csv, compromiso_Q_R.csv, consistencia_kalman.csv, correlacion_cruzada.csv, degradacion_movimiento.csv, dt_real_vs_nominal.csv, estadisticas_estatico.csv]
2026-11-02 Notas: el brazo se mueve en plano horizontal
    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
2026-11-02 Teleoperación con la cámara del teléfono (opción 1) + Kalman de ángulos
    - vision.py: seguimiento de 3 marcadores de color (HSV aprendido con un clic,
    máscara, apertura morfológica, centroide cerca de la posición anterior) y
    ángulos θ1, θ2 del brazo humano con la convención del robot.
    - kalman_camara.py: estado [θ1, ω1, θ2, ω2], medición del ángulo (H = [1 0 ...]),
    Δt real por cuadro, predicción sin actualización si un marcador no se ve,
    q = r·(2π f_n)^4 (frecuencia natural del filtro en régimen).
    - teleop_camara.py: DroidCam/webcam, teclas para aprender colores, pose de
    referencia, medir R de la cámara, fuente crudo/Kalman, Q, enviar al robot
    (arranca en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
2026-11-03 Teleop cámara: el error sugiere el puerto 4747 si falta en la URL
    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
    [teleop_camara.py]
2026-11-03 Notas completas del proyecto para continuar tras compactar
    Reorganiza CLAUDE.md: rol de profesor y estrategia, registro de comprensión y
    preguntas pendientes, entorno (COM3, DroidCam 192.168.1.38:4747), hardware,
    instrumentos E1/E2, mapa del código, datos reales y hallazgos, resultados,
    estado de la teleoperación con cámara, pendientes y trampas conocidas.
    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
2026-11-03 Teleop cámara: marcadores ArUco (cuadros impresos) en vez de colores
    El azul claro del hombro casi no se detectaba con color. ArUco usa contraste
    blanco/negro y un ID por marcador: funciona con poca o mucha luz y no se
    confunde con el fondo. Colores quedan como respaldo (--modo color).
    - vision.py: DetectorAruco y DetectorColor
    - generar_marcadores.py + docs/marcadores_aruco.pdf para imprimir
    - hombro de memoria si no se ve un cuadro; tecla D de diagnóstico
    - texto con fondo oscuro (legible en OpenCV 5)
    - 2 pruebas nuevas (28 pasan)
    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
2026-11-03 Teleop: video sin retraso acumulado, ArUco robusto al desenfoque y análisis E8
    - video_rapido.py: lector en un hilo que usa siempre el cuadro más nuevo
    (MJPEG directo de DroidCam). Antes el retraso crecía hasta >2 s
    (prueba_latencia_video.py lo mide); ahora se queda en ~17 ms.
    - La ventana ya no se congela esperando cuadros.
    - vision.py: seguimiento por cercanía cuando el cuadro sale borroso.
    - kalman_camara.py: en oclusiones largas la velocidad se frena.
    - Sesiones con tiempos (detección, Kalman, espera) y giroscopio del robot.
    - analisis_teleop.py: crudo vs Kalman en los mismos cuadros (suavidad,
    órdenes al servo, retraso, cómputo, oclusiones, retraso y vibración del
    robot)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
    [metricas_teleop_completas.csv, sesion_01.csv, sesion_01_robot.csv, sesion_02.csv, sesion_02_robot.csv]
2026-11-03 Teleop: medición parcial en Kalman, guía de prueba final y evidencia E8
    - kalman_camara.py: si la muñeca está tapada, H usa solo la fila de θ1
    (en simulación el error de θ1 en oclusión baja de 19° a 0.3°).
    - docs/PRUEBA_FINAL.md: los 10 minutos antes de entregar, con planes B.
    - ENTREGAS (E8 y respuesta C2), SUSTENTACION, docs/05, README y CLAUDE.md
    actualizados. 30 pruebas pasan.
    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
    [metricas_teleop_completas.csv, sesion_01.csv, sesion_02.csv, sesion_02_robot.csv]
2026-11-08 Notas: correo de Git del usuario y cambio de computador
    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
2026-11-08 Notas: ruta del proyecto en el computador nuevo
    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
2026-11-08 Revisión final E2: pantalla nueva, q de la cámara corregida y guía de sustentación
    - panel_teleop.py: video + panel con estado, marcadores, θ crudo/Kalman y dos
    gráficas en vivo (visualización comparativa E8); pista del siguiente paso.
    - teleop_camara.py: clase Robot (lee # cfg, arranque suave, errores claros),
    --video IP, --puerto auto, tecla M (espejo), teclas sin importar mayúsculas,
    cerrar con la X, mensajes temporales, reinicio de Kalman tras cortes.
    - kalman_camara.py: q = r·Δt·(2π f_n)^4 (faltaba Δt: el filtro casi no
    filtraba); caracterizar_q y tabla configuraciones_q_camara.md.
    - video_rapido.py: se reconecta solo si DroidCam se corta.
    - sincronizar.py: no se cu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
    [configuraciones_q_camara.csv, metricas_teleop_completas.csv, sesion_01.csv, sesion_02.csv, sesion_02_robot.csv]
2026-11-10 Firmware 1.3: pines automáticos para ESP32-S3 (servos 4/5, I2C 8/9)
    El ESP32 nuevo es un ESP32-S3, que no tiene los GPIO 22 ni 25. El firmware
    elige los pines según la placa compilada y la línea # cfg informa placa y
    pines. Guía de conexiones con la tabla del S3 y cómo entrar en modo de
    descarga (BOOT + RST).
    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
2026-11-10 Notas: ESP32-S3 con firmware 1.3 funcionando (IMU ok)
    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
2026-11-10 Firmware 1.4: lectura I2C robusta (reintentos, timeout 5 ms, 100 kHz)
    Con el ESP32-S3 aparecían error_i2c sueltos al mover los servos y se perdían
    muestras. Ahora cada lectura se reintenta hasta 3 veces, un fallo no bloquea
    más de 5 ms, el bus va a 100 kHz (más tolerante al ruido) y tras 5 fallos
    seguidos se reinicia el bus y se reconfiguran las IMU. La línea # cfg
    informa la frecuencia del I2C y los contadores de reintentos y reinicios.
    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
    [adquisicion.ino, config_imu.py]
2026-11-10 Notas: el ESP32 nuevo es clásico (pines de siempre); firmware 1.4 cargado
    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
2026-11-10 Teleoperación: sesion_01
    [sesion_01.csv, sesion_01_robot.csv]
2026-11-10 Teleoperación: sesiones y resultados
    [configuraciones_q_camara.csv, metricas_teleop_completas.csv]
2026-11-10 Teleop: pedir la línea # cfg al conectar (el panel muestra fw e IMU ok)
    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
2026-11-10 Latencia de video: guardar la medición en resultados/latencia_video.json (para el informe)
    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
2026-11-10 Localizadores de evidencias E5–E9 y niveles de la rúbrica E2 v2.0
    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
2026-11-10 Informe de la Entrega 2 generado por código (docx + pdf)
    - python/generar_informe.py: arma el informe (portada, resumen, marco teórico,
    metodología, resultados, discusión, conclusiones, referencias y anexo de
    código) leyendo todos los números y figuras de resultados/. Usa las
    sesiones reales de teleoperación si existen; si no, las sintéticas
    marcadas como tales y una nota de pendiente. Opción --foto.
    - prueba_latencia_video.py guarda resultados/latencia_video.json.
    - docs/informe/Informe_Entrega2.docx y .pdf (15 páginas, 10 figuras).
    - python-docx en requirements; prueba que el informe se genera.
    Claude-Session: https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
2026-11-10 Notas: estado de grabación, informe y rúbrica Lab 3 descartada
    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
2026-11-10 Teleoperación: sesion_02
    [sesion_02.csv, sesion_02_robot.csv]
2026-11-10 Teleoperación: sesion_03
    [sesion_03.csv, sesion_03_robot.csv]
2026-11-10 Teleoperación: sesion_04
    [sesion_04.csv, sesion_04_robot.csv]
2026-11-10 Teleop real: descartar la IMU del robot sin señal e informe con las sesiones reales
    - analisis_teleop: primera_falla_imu detecta giro 0.000 exacto (IMU caída) y
    mide el robot solo en el tramo válido (sesion_04 sin datos de robot).
    - generar_informe: sección 4.6 con las sesiones reales (crudo = sesion_03,
    Kalman = sesion_04), falla de sensor declarada; foto_montaje.* automática.
    - Prueba nueva (36 pasan).
    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
    [metricas_teleop_completas.csv]
2026-11-10 Informe de la Entrega 2 en formato IEEE (docx + pdf)
    - generar_informe_ieee.py: carta a dos columnas, Times 10 pt, Resumen y Abstract,
    secciones en números romanos, 12 ecuaciones de Word numeradas, TABLA I-VI,
    Fig. 1-7 y referencias [1]-[7]; todos los números salen de resultados/.
    - Títulos formales en las gráficas de teleoperación.
    - Se retira el informe largo no IEEE (el generador queda como lector de datos).
    - Prueba nueva (37 pasan).
    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
